Kaliux2412/Experimento_Abordo/Documentation/README.md

Aqui se explicará más a detalle cuál fue el proceso de desarrollo del experimento abordo.
