Kaliux2412/Experimento_Abordo/Archivos SVG/Placa 1 (LoRa).pdf

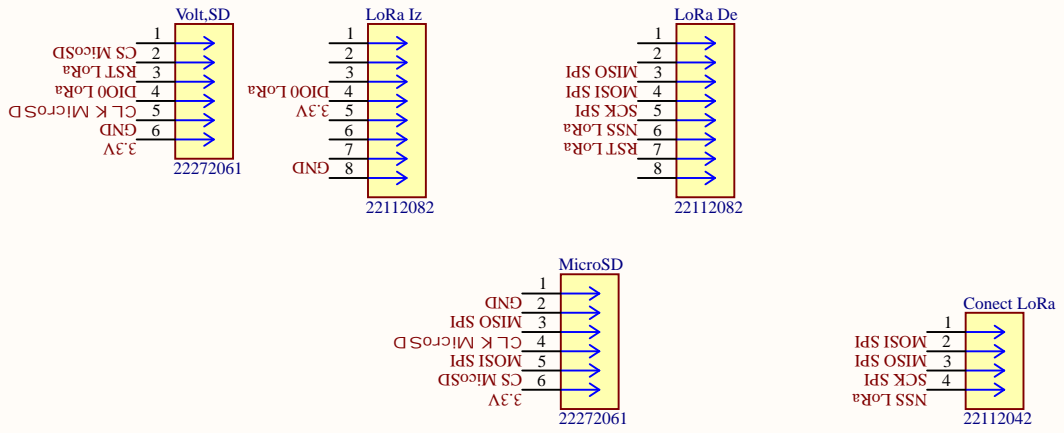
[picture p2: page 1]

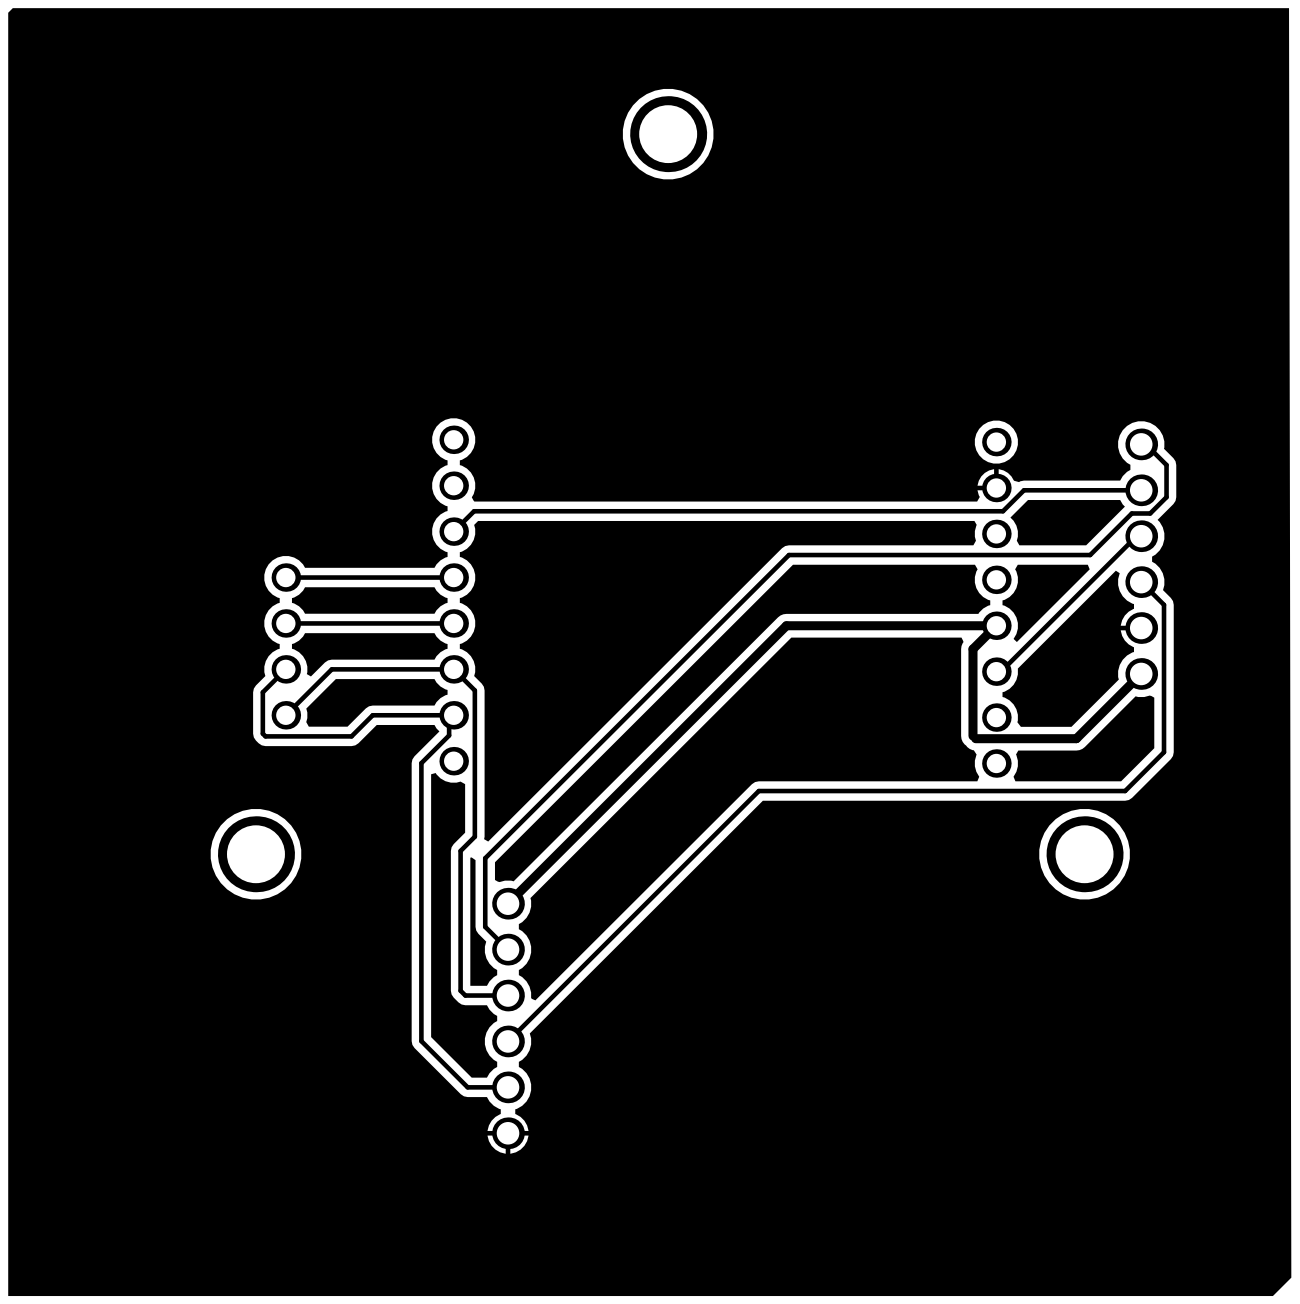
[picture p3: page 3]

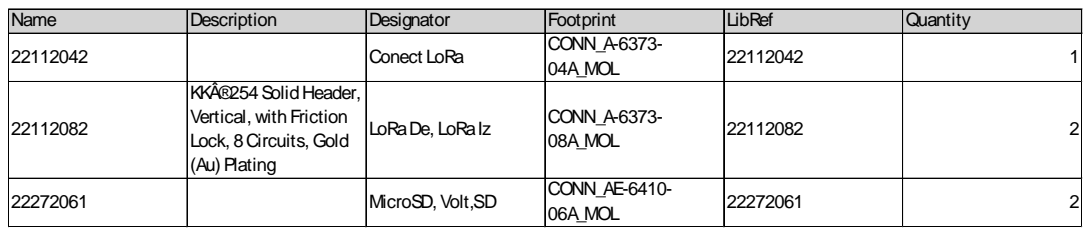
[picture p4: page 4]

Name | Description | Designator | Footprint | LibRef | Quantity
22112042 | | Conect LoRa | CONN_A-6373-04A_MOL | 22112042 | 1

22112082 | KKÂ®254SolidHeader, Vertical, withFriction Lock, 8Circuits, Gold (Au)Plating | LoRaDe, LoRaIz | CONN_A-6373-08A_MOL | 22112082 | 2

22272061 | | MicroSD, Volt,SD | CONN_AE-6410-06A_MOL | 22272061 | 2
