Kaliux2412/Experimento_Abordo/Archivos SVG/Placa 2 (GPS).pdf

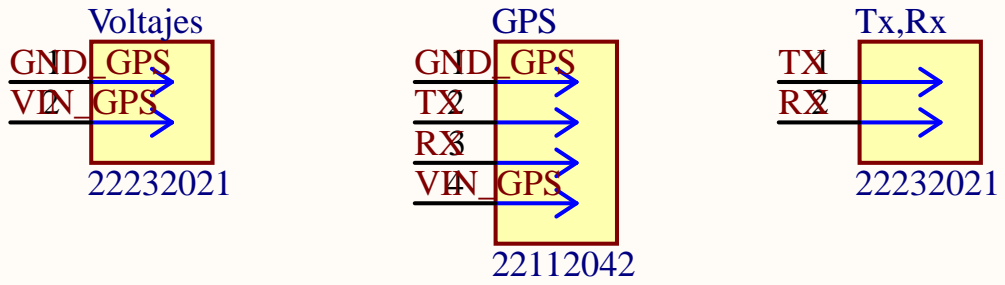
[picture p5: page 1]

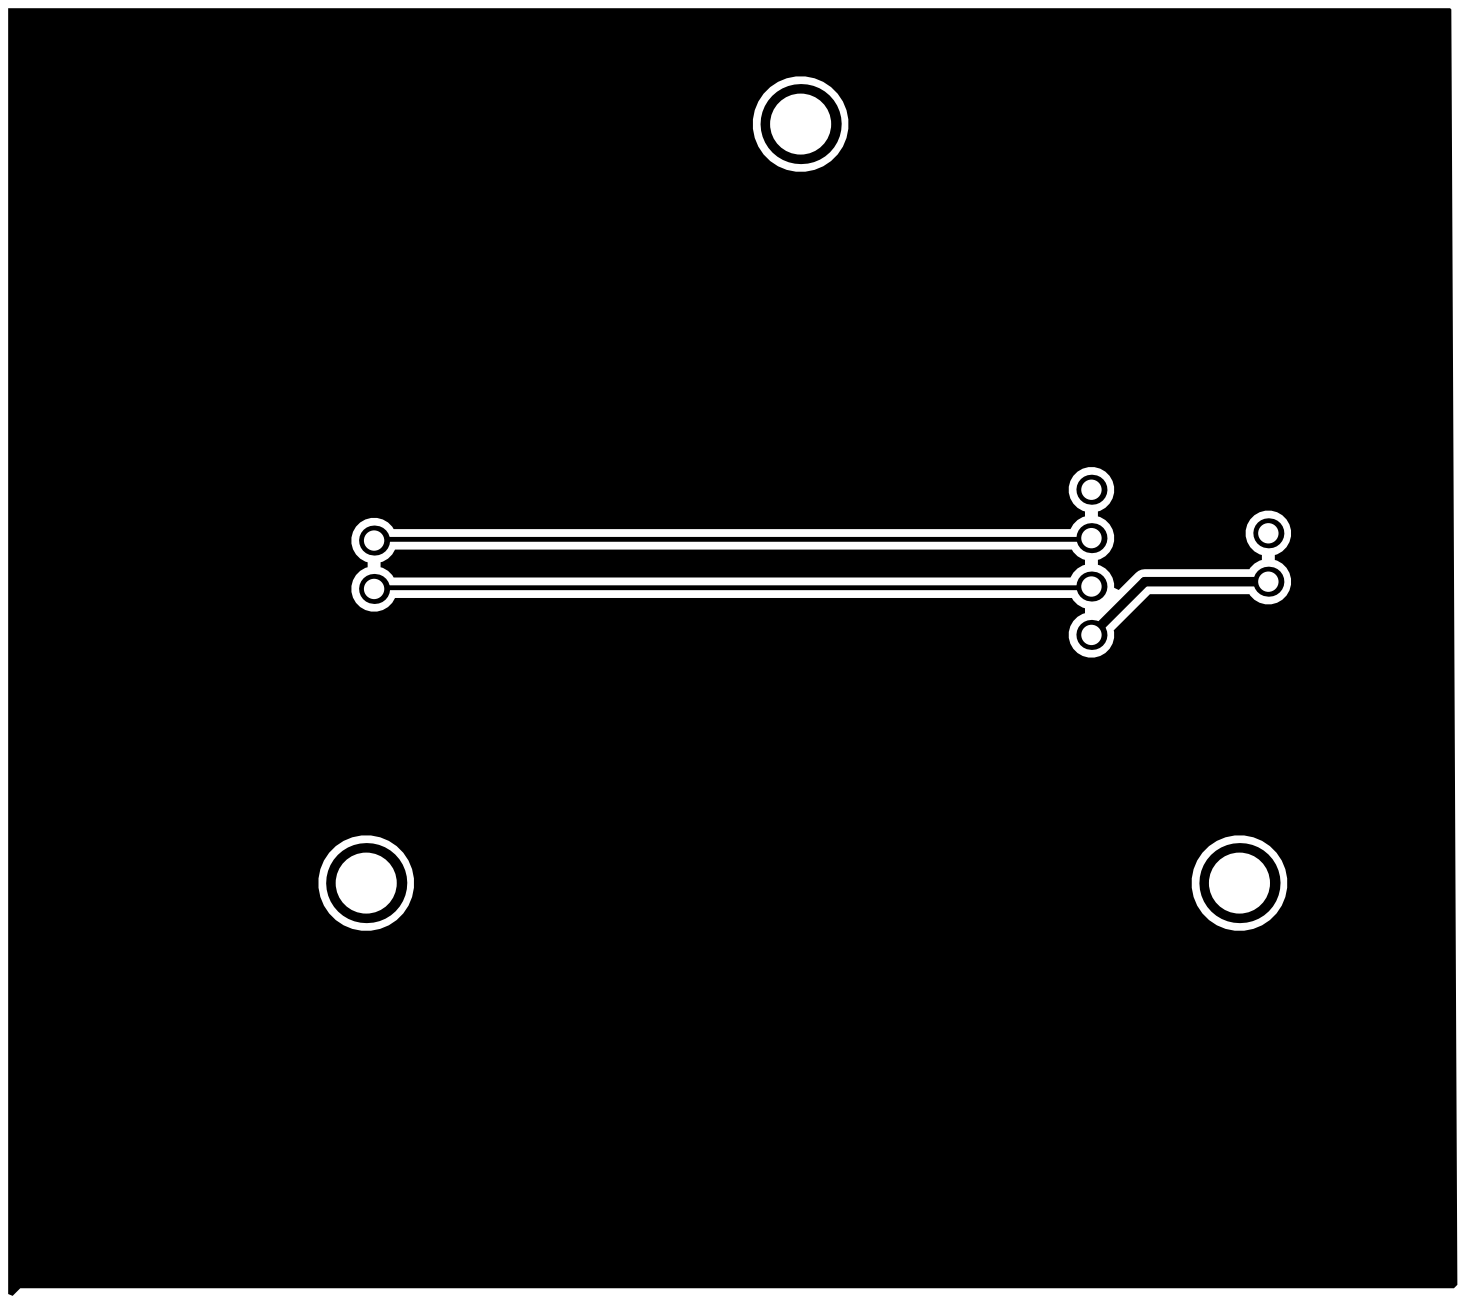
[picture p6: page 3]

Name | Description | Designator | Footprint | LibRef | Quantity
22112042 | | GPS | CONN_A-6373-04A_MOL | 22112042 | 1

22232021 | Connector Header ThroughHole2 position0.100 (2.54mm) | Tx,Rx, Voltajes | CONN_A-6373-02A_MOL | 22232021 | 2
