Kaliux2412/Experimento_Abordo/Archivos SVG/Placa 3 (ESP32).pdf

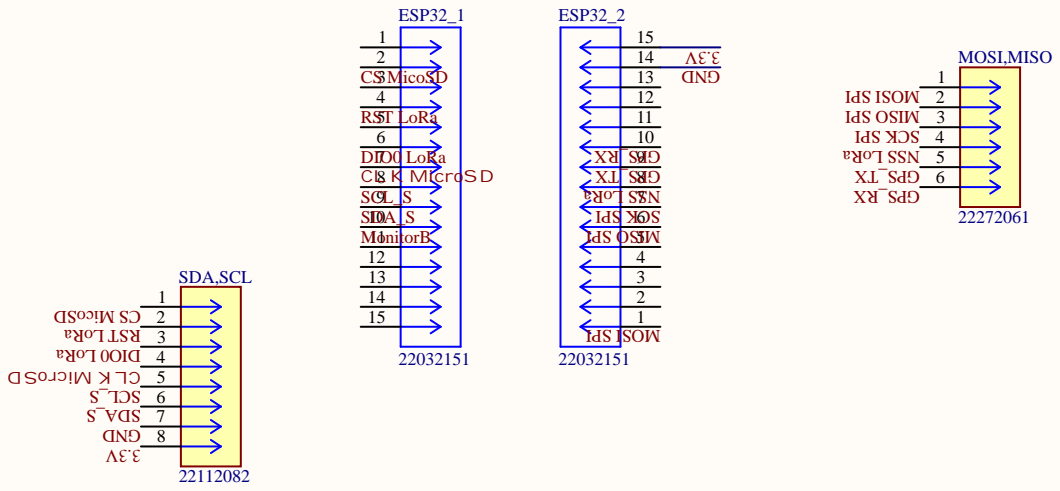
[picture p7: page 1]

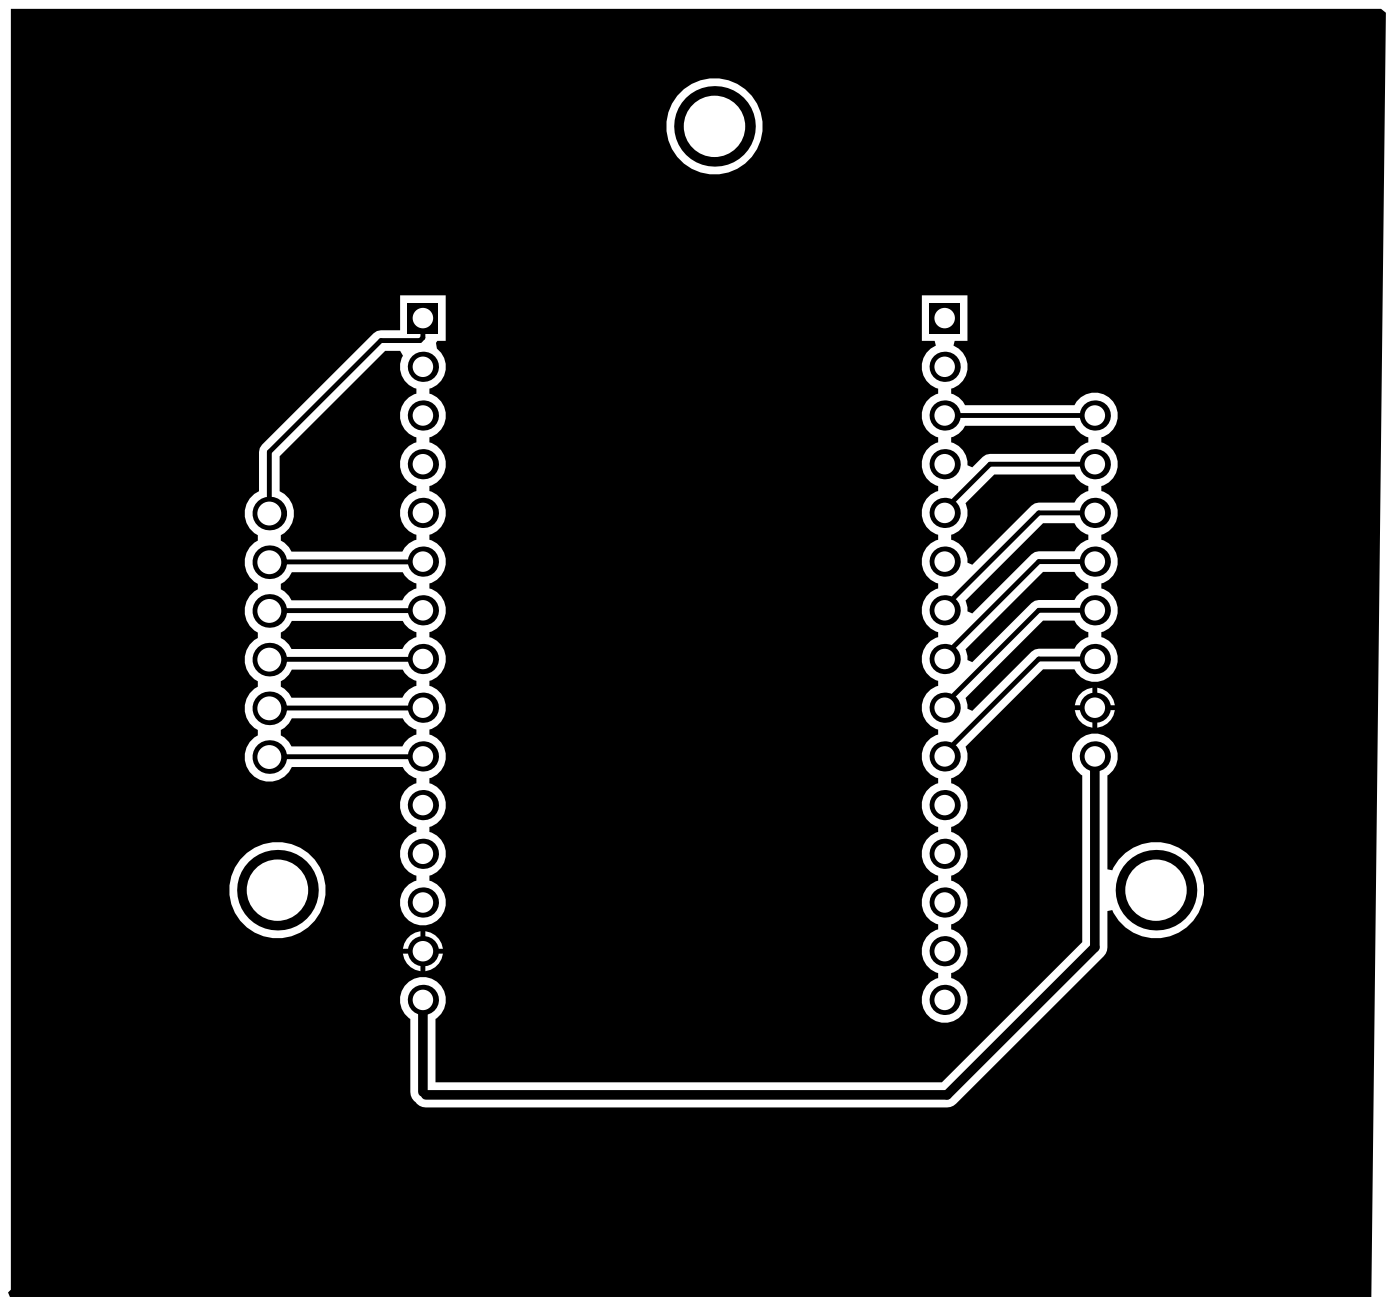
[picture p8: page 3]

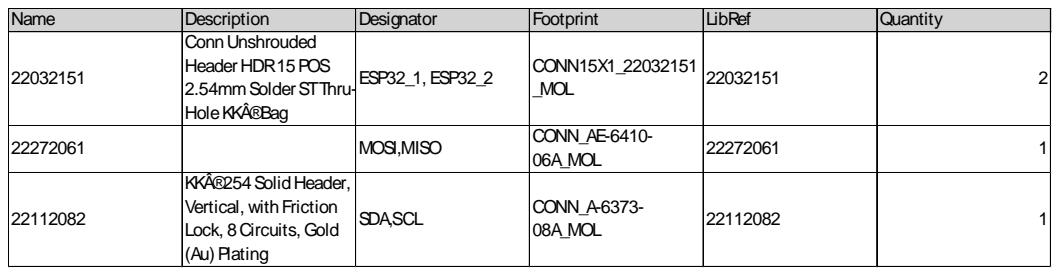
[picture p9: page 4]

Name | Description | Designator | Footprint | LibRef | Quantity
22032151 | ConnUnshrouded Header HDR15POS 2.54mmSolderSTThru-HoleKKÂ®Bag | ESP32_1, ESP32_2 | CONN15X1_22032151 _MOL | 22032151 | 2

22272061 | | MOSI,MISO | CONN_AE-6410-06A_MOL | 22272061 | 1

22112082 | KKÂ®254SolidHeader, Vertical, withFriction Lock, 8Circuits, Gold (Au)Plating | SDA,SCL | CONN_A-6373-08A_MOL | 22112082 | 1
