Kaliux2412/Experimento_Abordo/Documentation/IGNIS-1_esquematico_v0.pdf

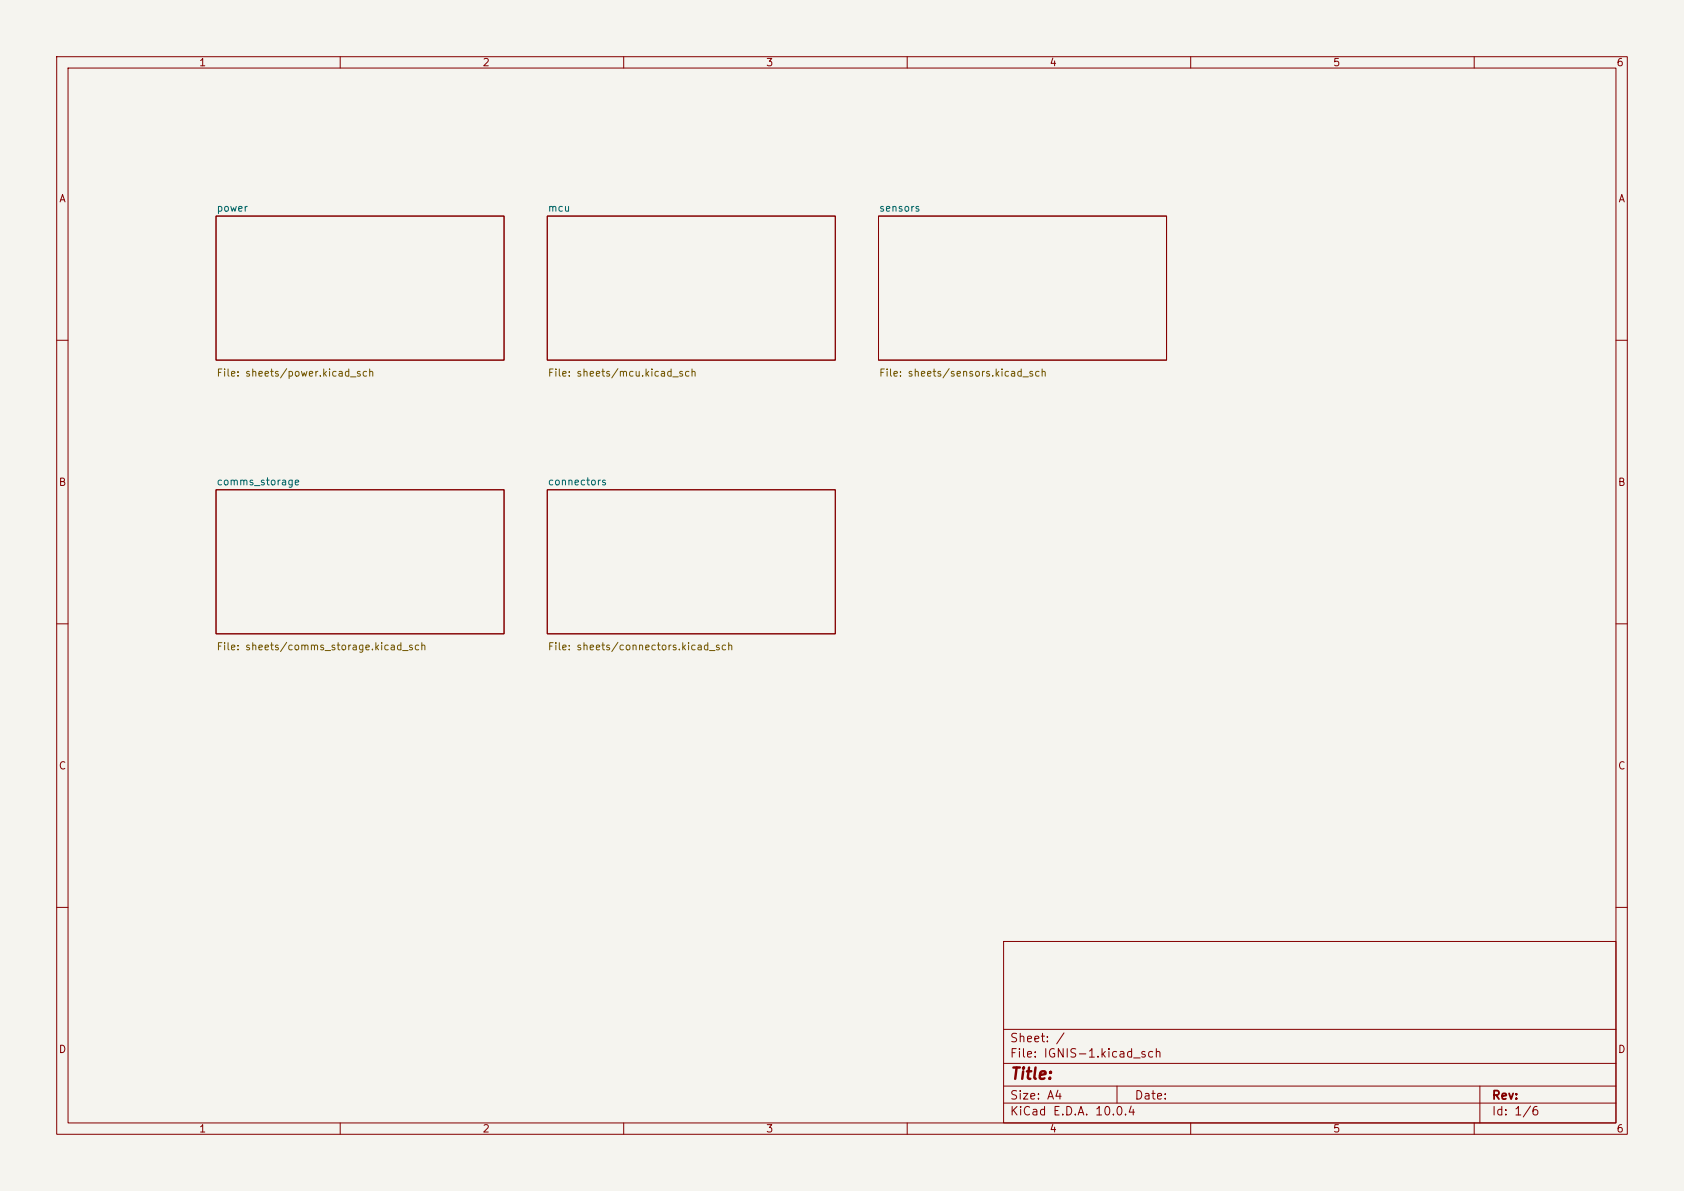
[picture p10: page 1]

sensors File: sheets/sensors.kicad_sch

connectors File: sheets/connectors.kicad_sch

Size: A4 | Rev:
KiCad E.D.A. 10.0.4 | Id: 1/6

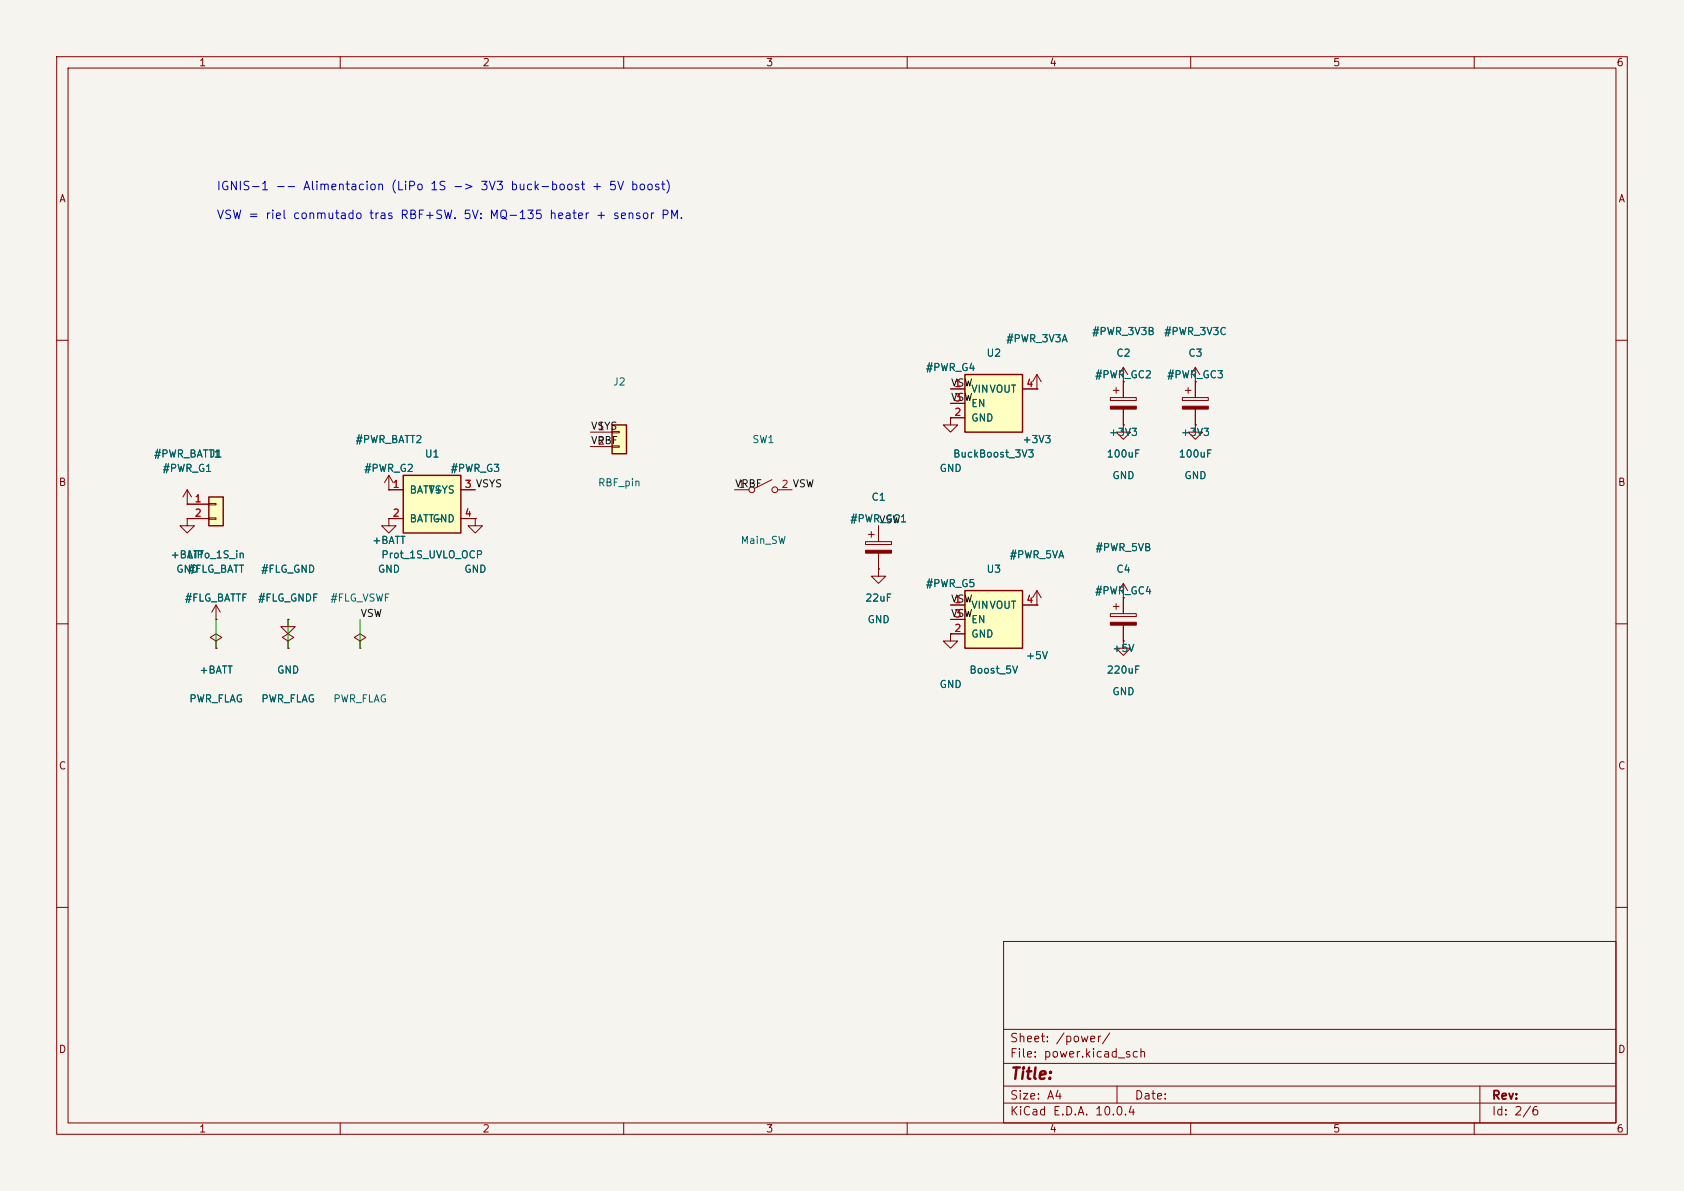
[picture p11: page 2]

IGNIS-1 -- Alimentacion (LiPo 1S -> 3V3 buck-boost + 5V boost)

VSW = riel conmutado tras RBF+SW. 5V: MQ-135 heater + sensor PM.

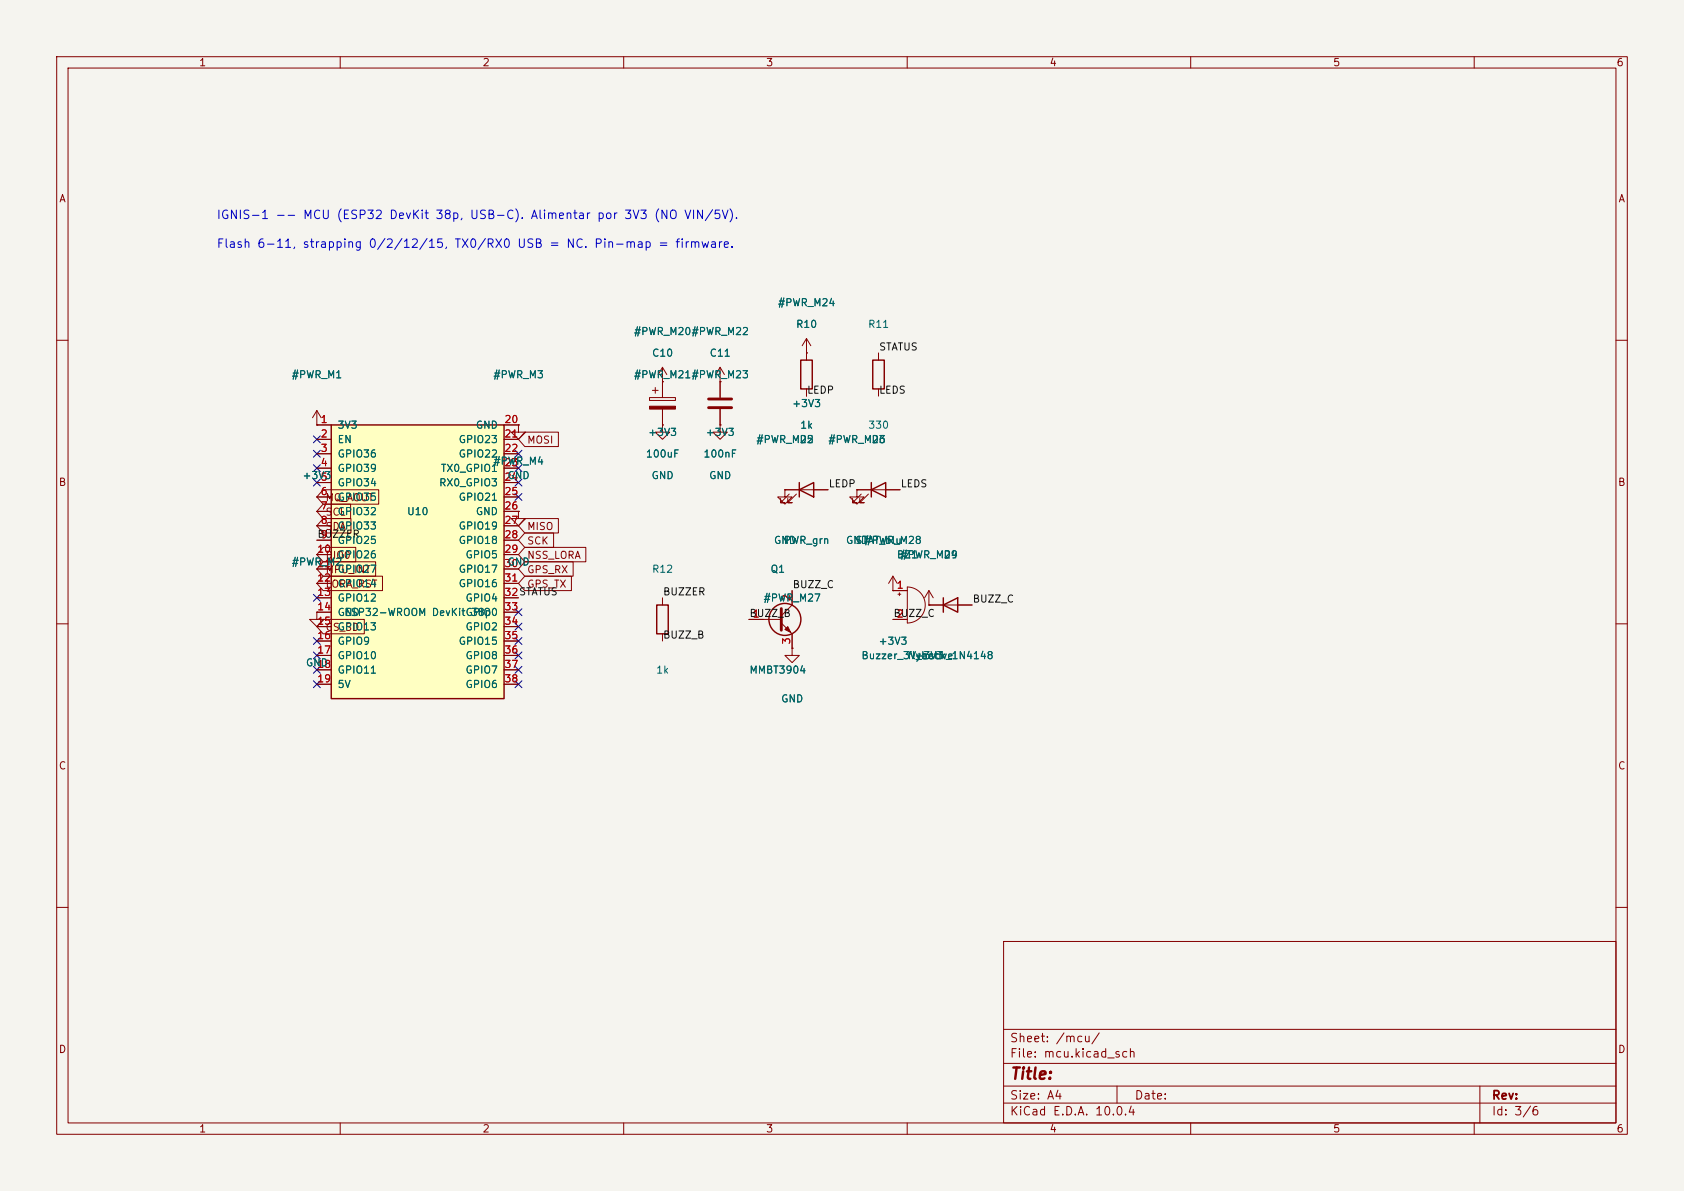
[picture p12: page 3]

BUZZ_B Flash 6-11, strapping 0/2/12/15, TX0/RX0 USB = NC. Pin-map = firmware.

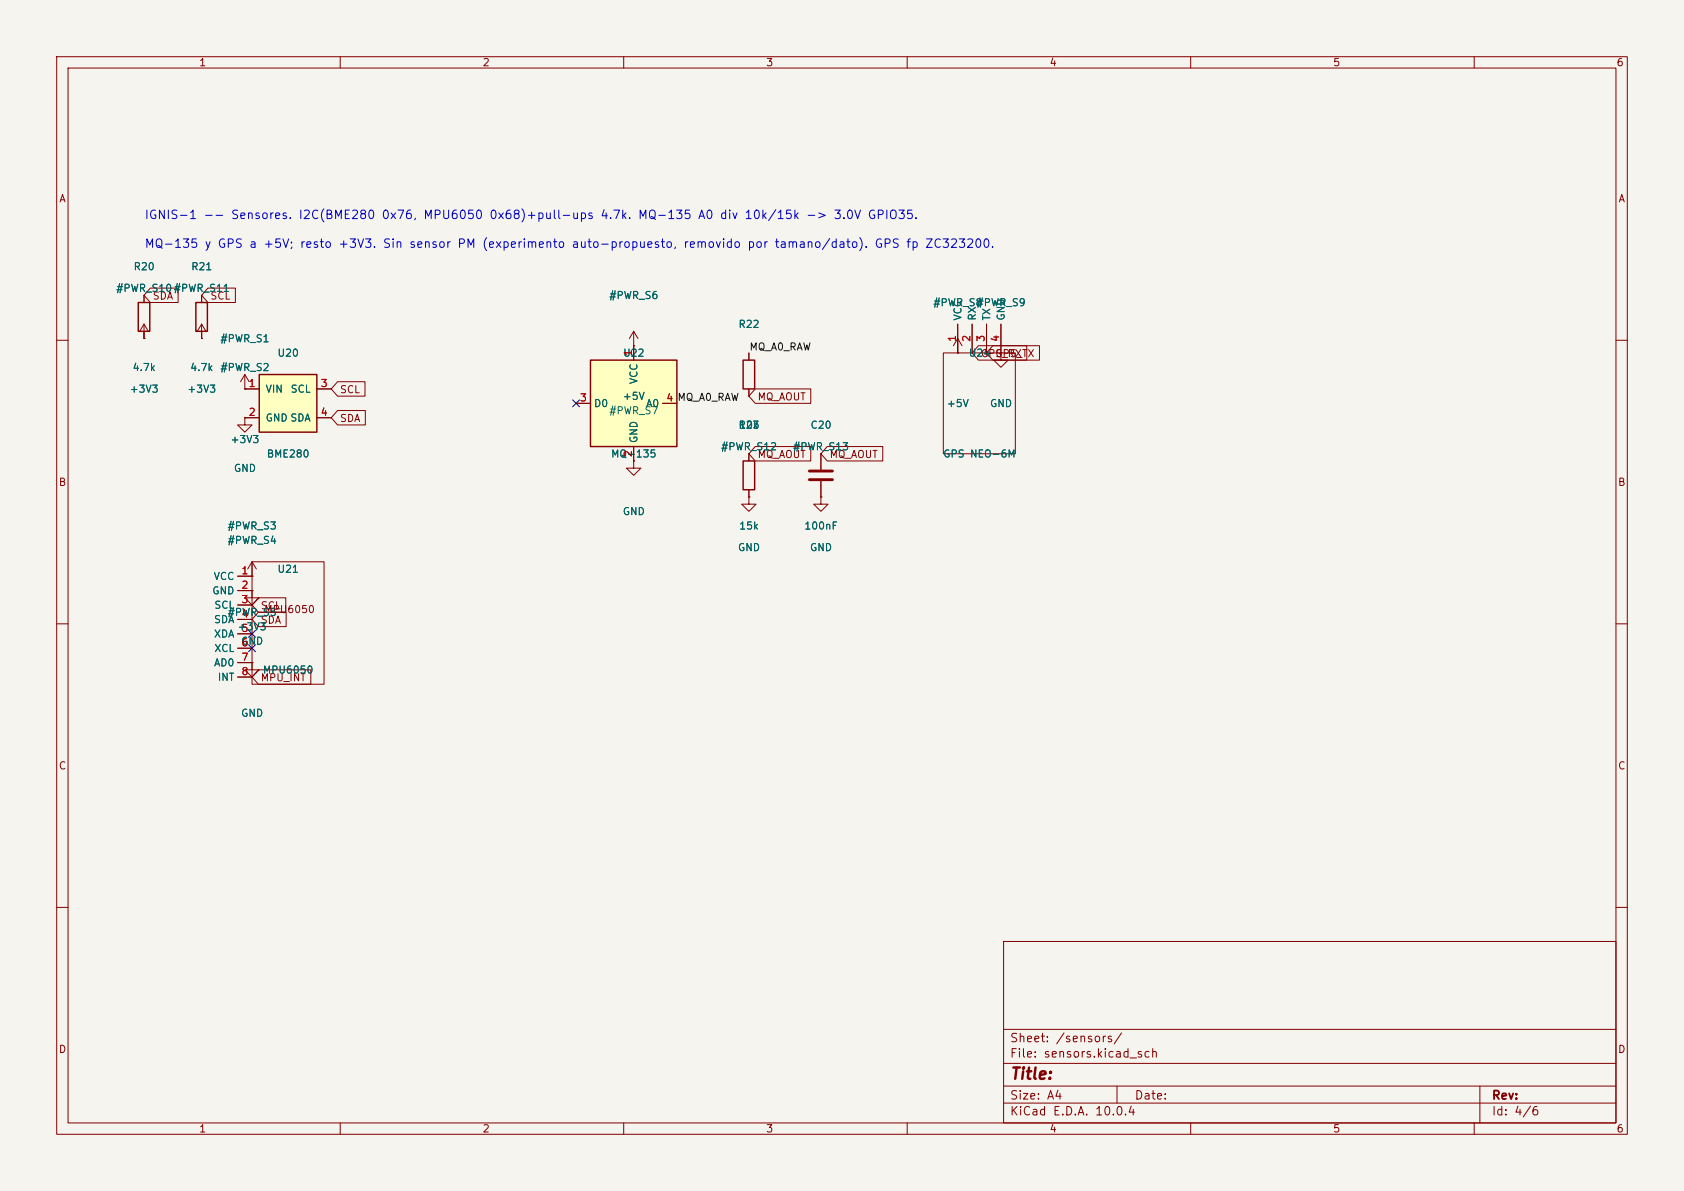
[picture p13: page 4]

IGNIS-1 -- Sensores. I2C(BME280 0x76, MPU6050 0x68)+pull-ups 4.7k. MQ-135 A0 div 10k/15k -> 3.0V GPIO35. R20

MQ_A0_RAW MQ-135 y GPS a +5V; resto +3V3. Sin sensor PM (experimento auto-propuesto, removido por tamano/dato). GPS fp ZC323200.

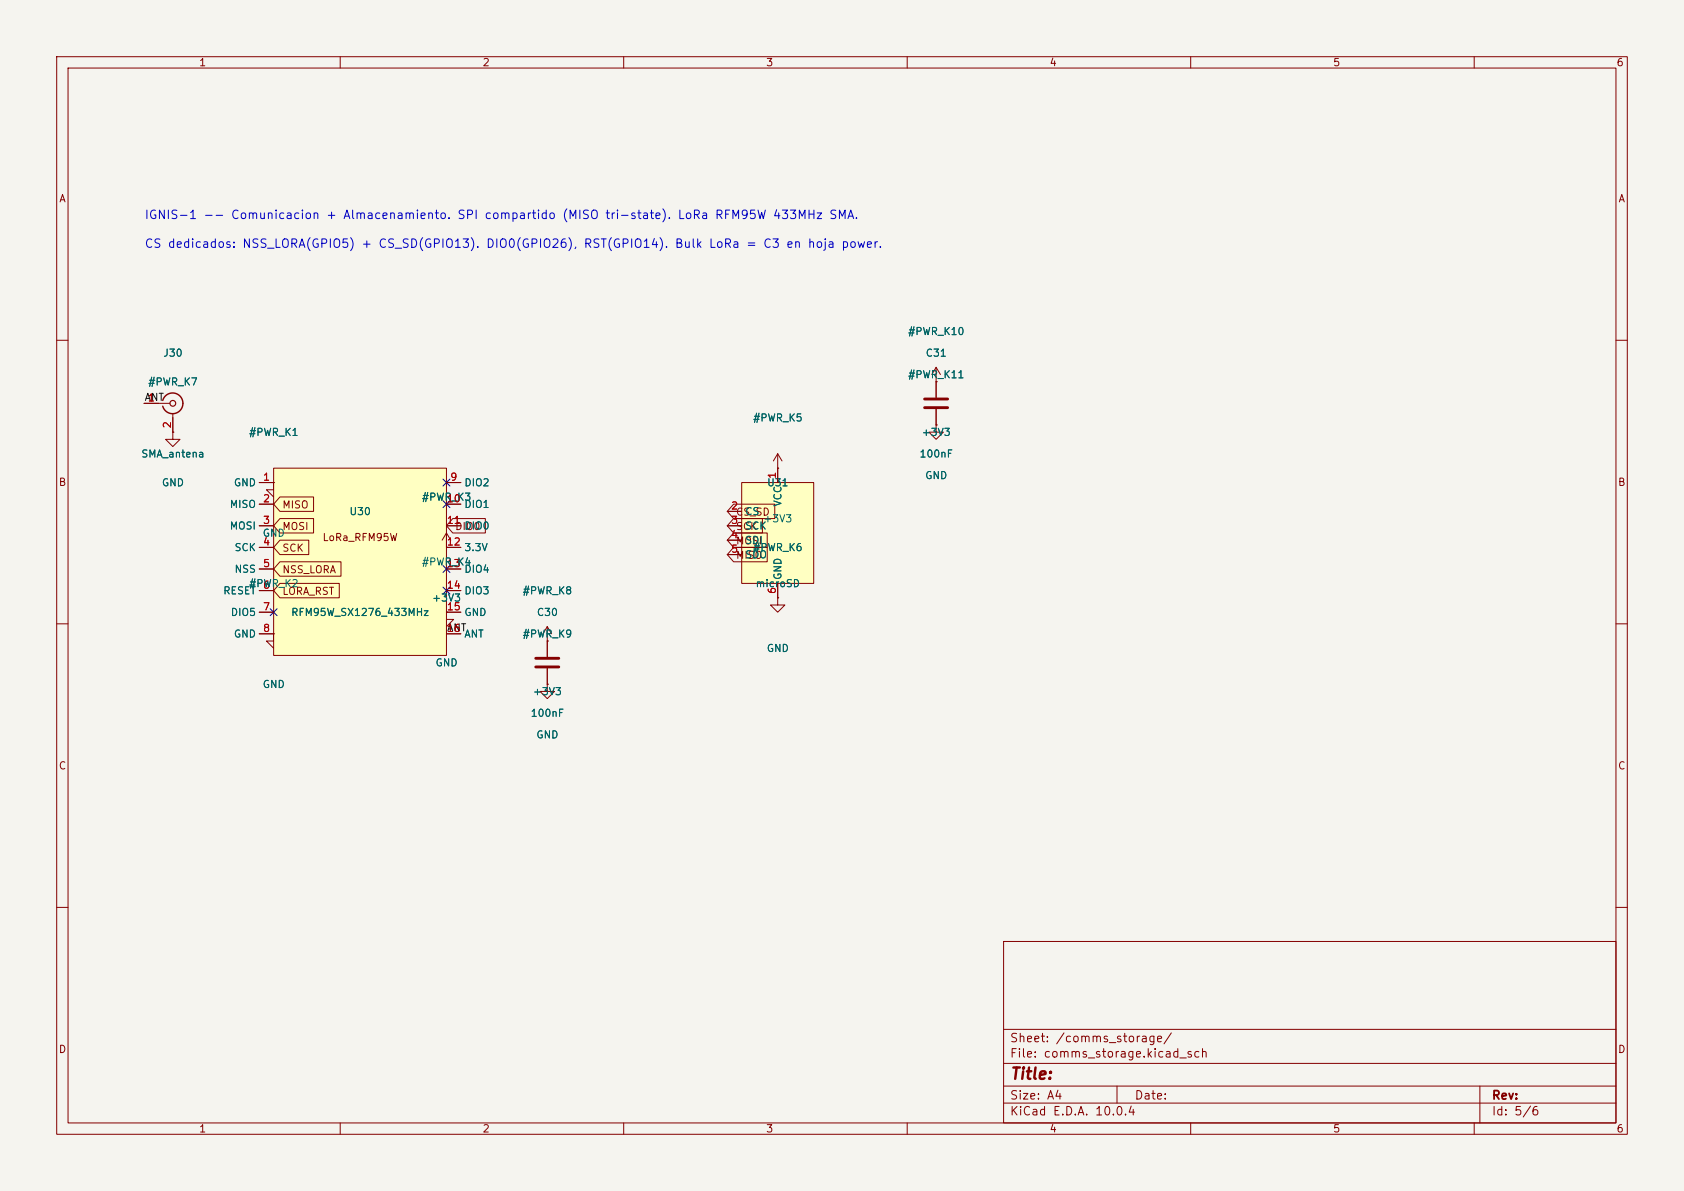
[picture p14: page 5]

IGNIS-1 -- Comunicacion + Almacenamiento. SPI compartido (MISO tri-state). LoRa RFM95W 433MHz SMA.

CS dedicados: NSS_LORA(GPIO5) + CS_SD(GPIO13). DIO0(GPIO26), RST(GPIO14). Bulk LoRa = C3 en hoja power.

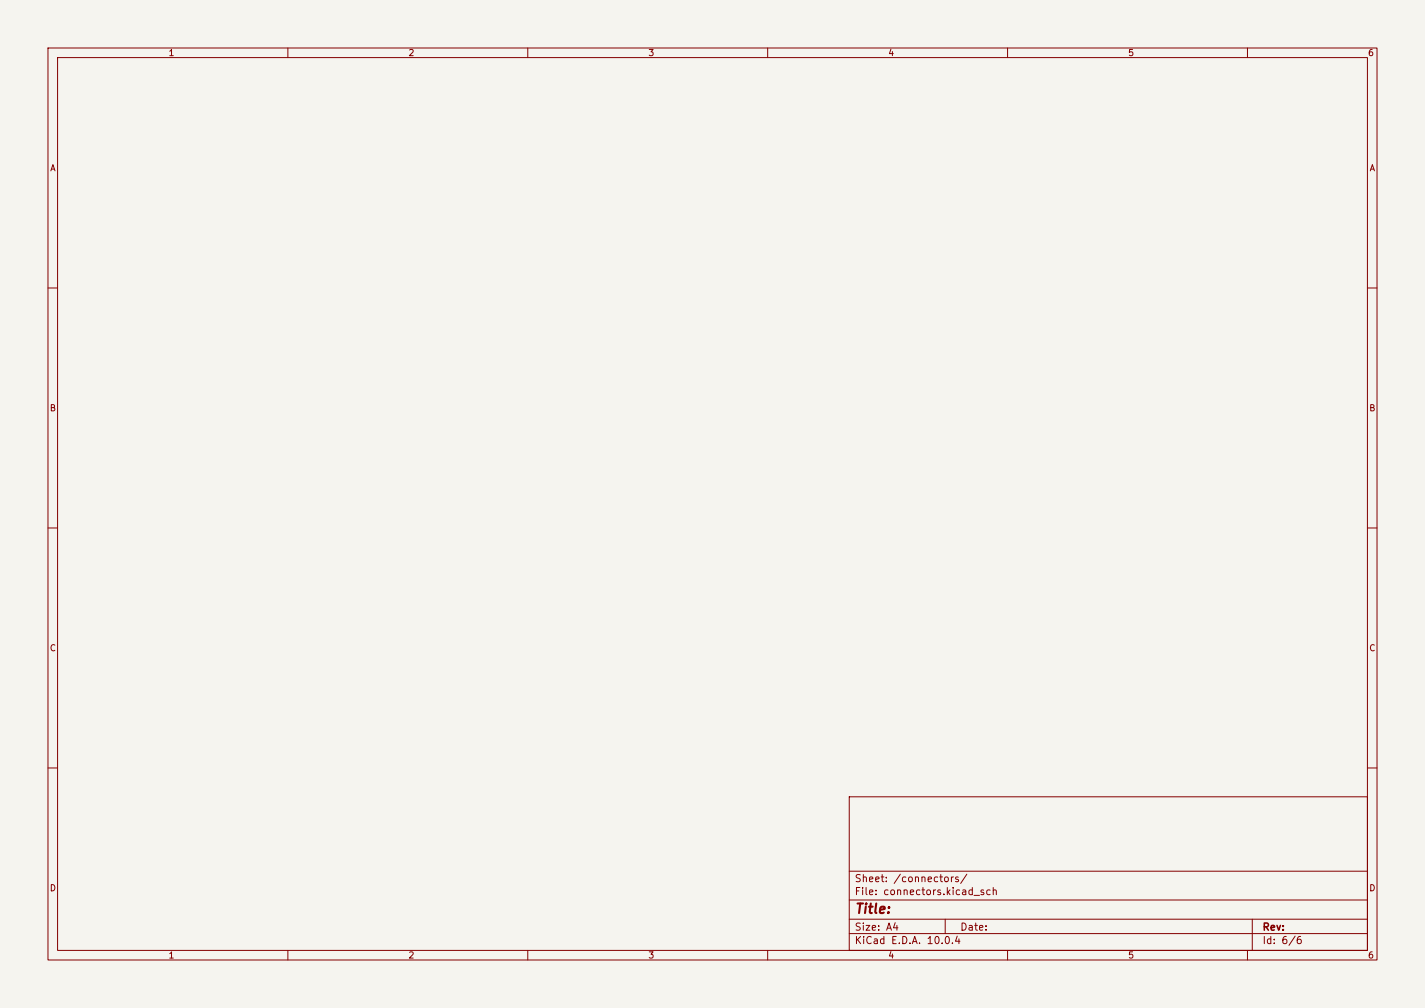
[picture p15: page 6]
