Kaliux2412/Experimento_Abordo/Documentation/IGNIS-1_placa_cerebro.pdf

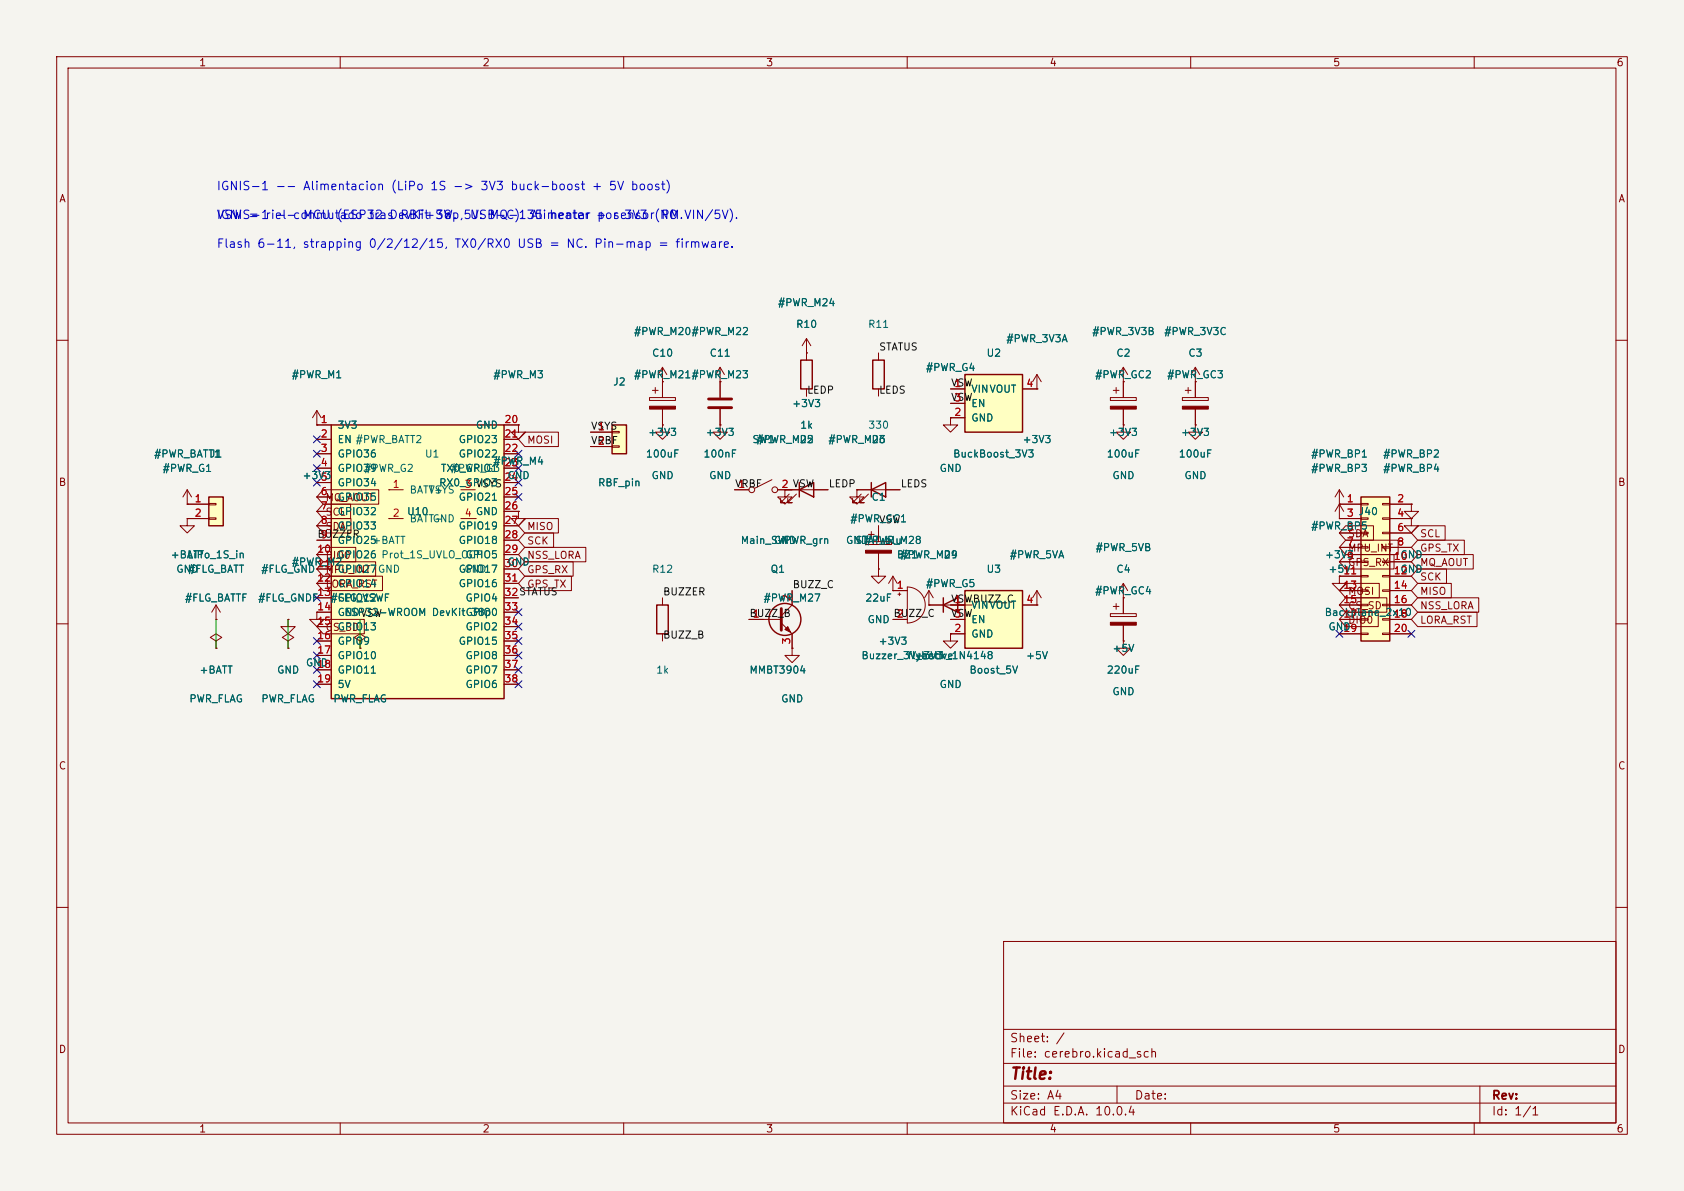
[picture p16: page 1]

IGNIS-1 -- Alimentacion (LiPo 1S -> 3V3 buck-boost + 5V boost)

IGNIS-1 -- MCU (ESP32 DevKit 38p, USB-C). Alimentar por 3V3 (NO VIN/5V).
VSW = riel conmutado tras RBF+SW. 5V: MQ-135 heater + sensor PM.

Flash 6-11, strapping 0/2/12/15, TX0/RX0 USB = NC. Pin-map = firmware.

Size: A4 | Rev:
KiCad E.D.A. 10.0.4 | Id: 1/1
