Kaliux2412/Experimento_Abordo/Documentation/IGNIS-1_placa_sensores.pdf

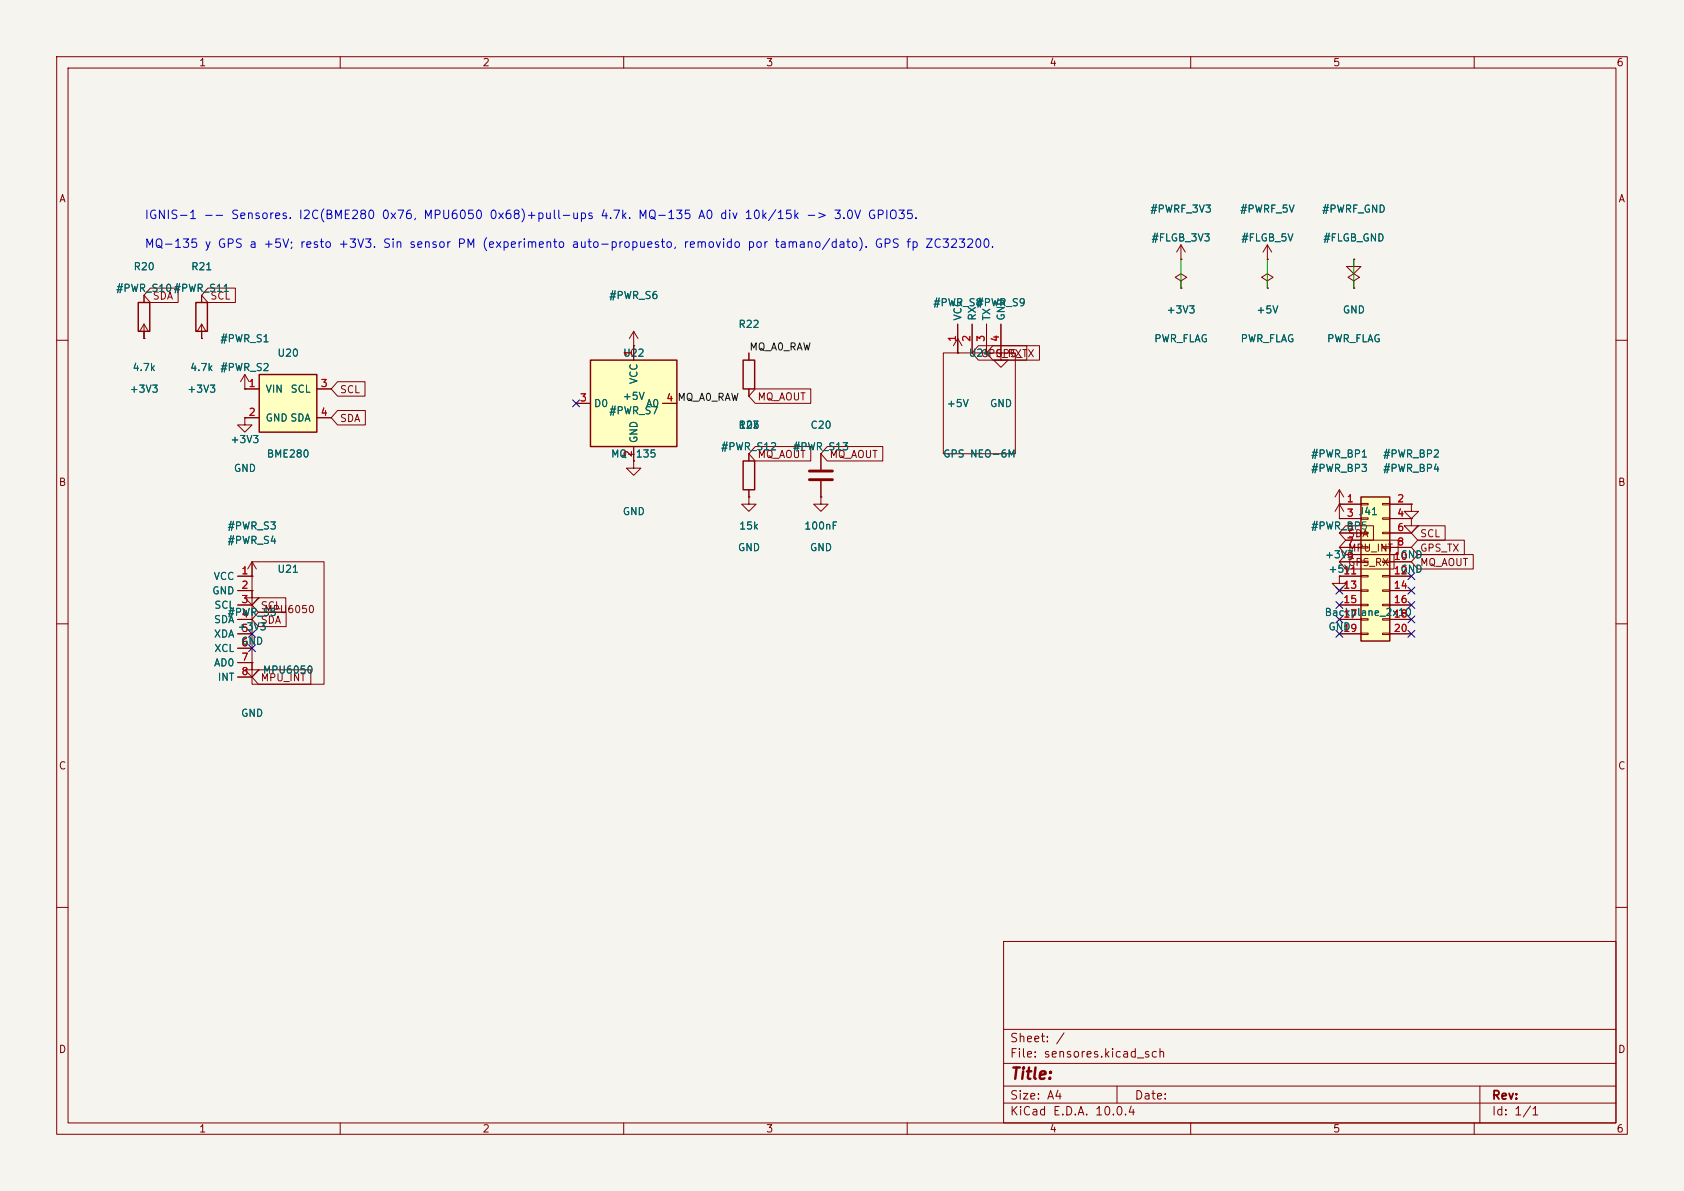
[picture p17: page 1]
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

MQ-135 y GPS a +5V; resto +3V3. Sin sensor PM (experimento auto-propuesto, removido por tamano/dato). GPS fp ZC323200. U20 BME280

Size: A4 | Rev:
KiCad E.D.A. 10.0.4 | Id: 1/1
