Kaliux2412/Experimento_Abordo/Archivos SVG/Placa5.pdf

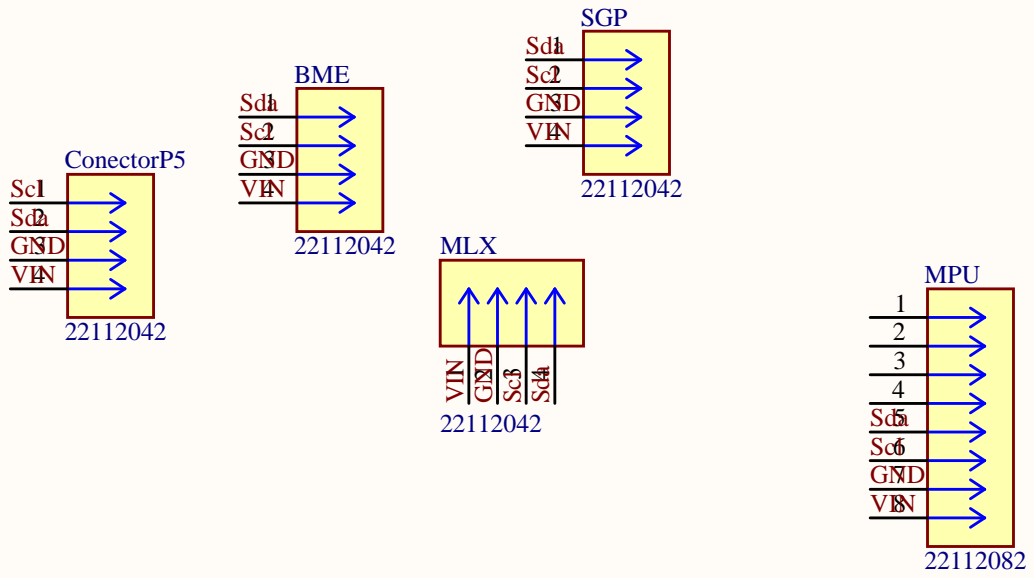
[picture p18: page 1]

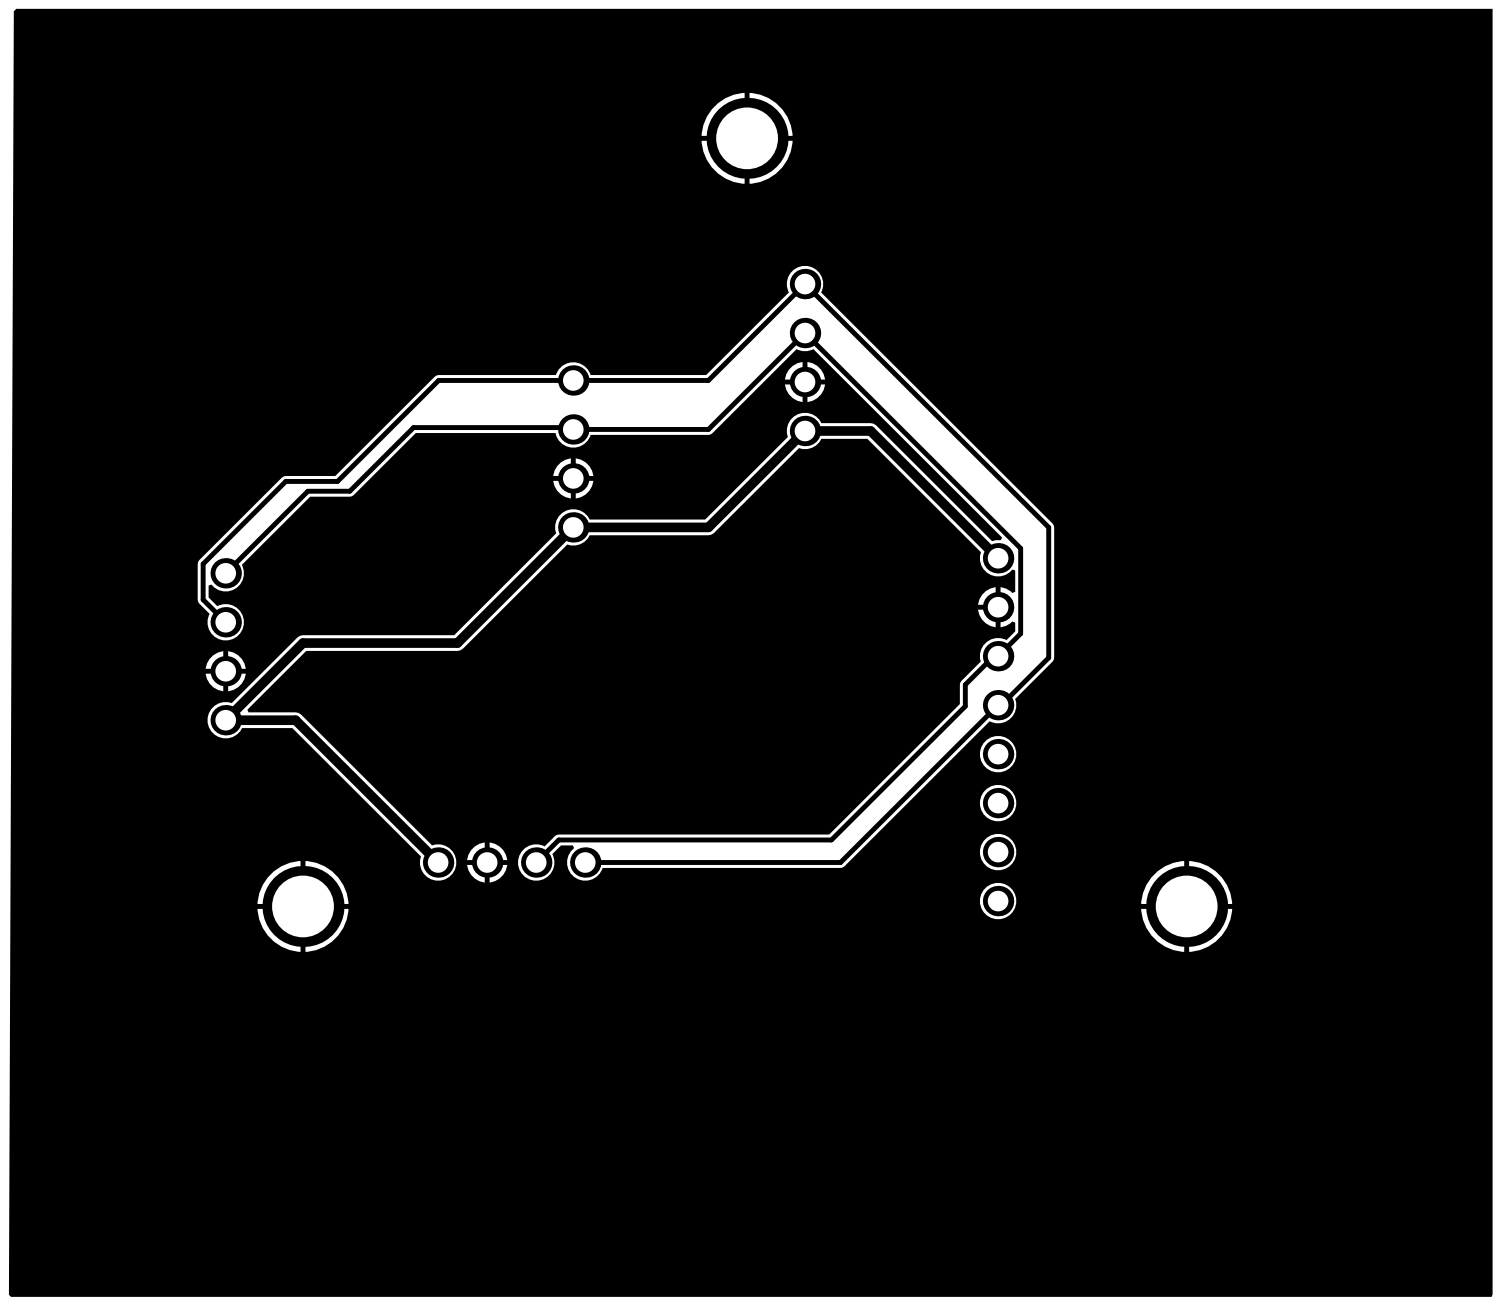
[picture p19: page 3]
