Kaliux2412/Experimento_Abordo/(list of files, drawings)

Other design files:
Altium/PCB_Project.PrjPcb
Altium/Placa1/Placa1.PcbDoc
Altium/Placa1/Placa1.SchDoc
Altium/Placa1/Placa 1 (LoRa).PrjPcb
Altium/Placa2/Placa2.SchDoc
Altium/Placa2/Placa 2 (GPS).PrjPcb
Altium/Placa2/Placa 2.PcbDoc
Altium/Placa3/Placa3.PcbDoc
Altium/Placa3/Placa3.SchDoc
Altium/Placa3/Placa 3 (ESP32).PrjPcb
Altium/Placa5.PrjPcb
Altium/Placa5/Placa5.PrjPcb
Altium/Placa5/Placa 5 (Sensores).SchDoc
Altium/Placa5/Placa 5.PcbDoc
Altium/Placa_Principal_PCB.PcbDoc
Altium/Placa_Principal_Schematic.SchDoc
