Kaliux2412/Experimento_Abordo/KiCad/IGNIS-1/placa_poder_cerebro/placa_poder_cerebro.kicad_pcb

## KiCad design KiCad/IGNIS-1/placa_poder_cerebro/placa_poder_cerebro.kicad_pcb (2026-07-23)

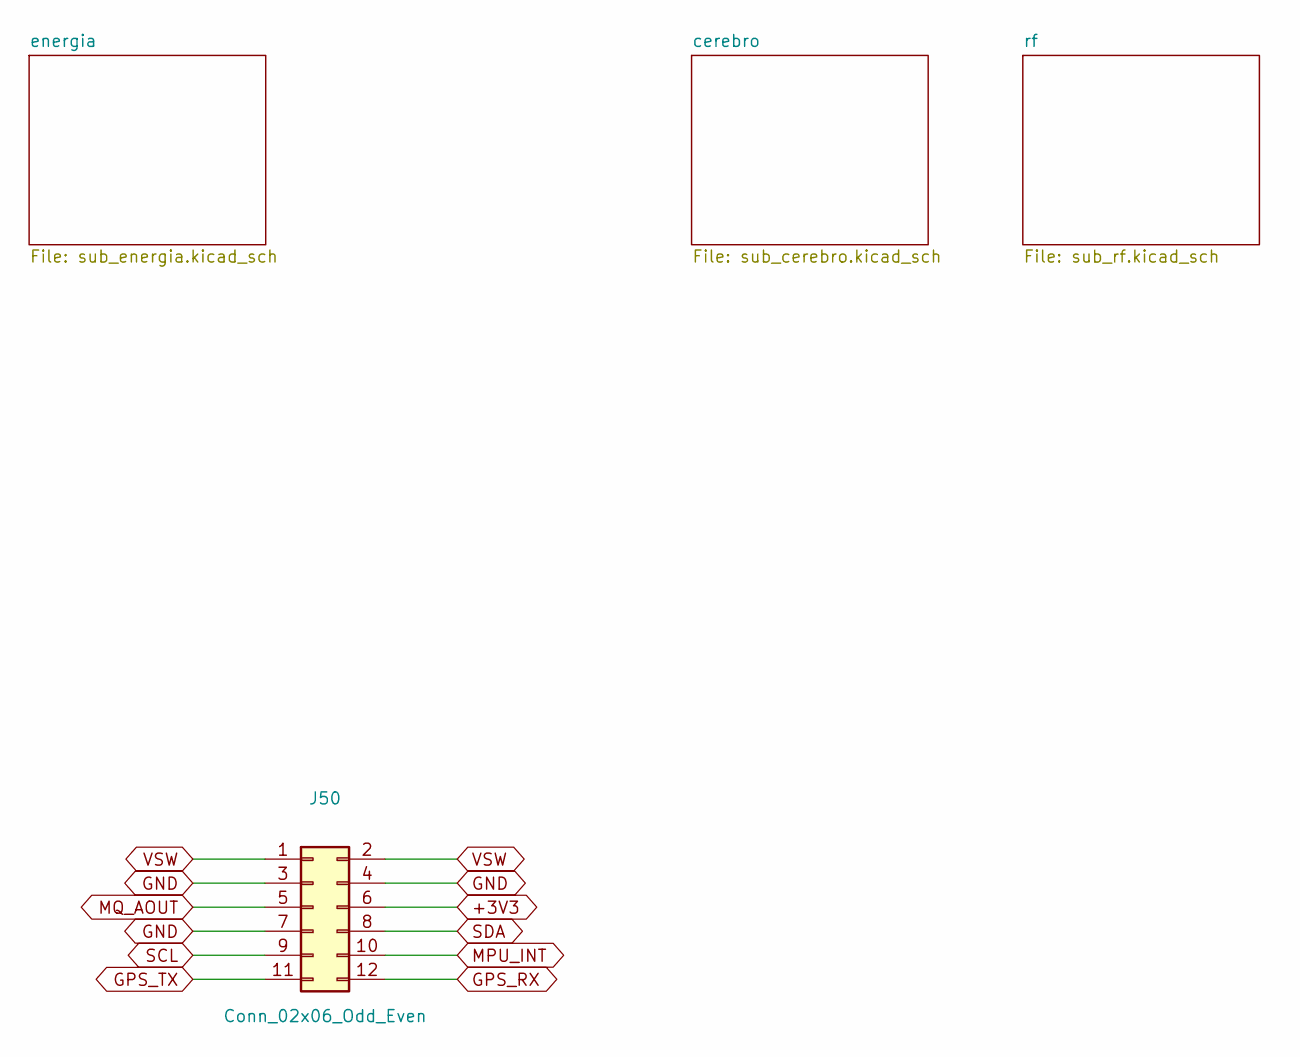
[picture p20: schematic placa_poder_cerebro.kicad_sch, IGNIS-1 Poder+Cerebro]

Parts:
J50: Conn_02x06_Odd_Even; PinHeader_2x06_P2.54mm_Vertical

Connections:
+3V3: J50.6; also elsewhere on the board
GND: J50.3, J50.4, J50.7; also elsewhere on the board
GPS_RX: J50.12; also elsewhere on the board
GPS_TX: J50.11; also elsewhere on the board
MPU_INT: J50.10; also elsewhere on the board
MQ_AOUT: J50.5; also elsewhere on the board
SCL: J50.9; also elsewhere on the board
SDA: J50.8; also elsewhere on the board
VSW: J50.1, J50.2; also elsewhere on the board

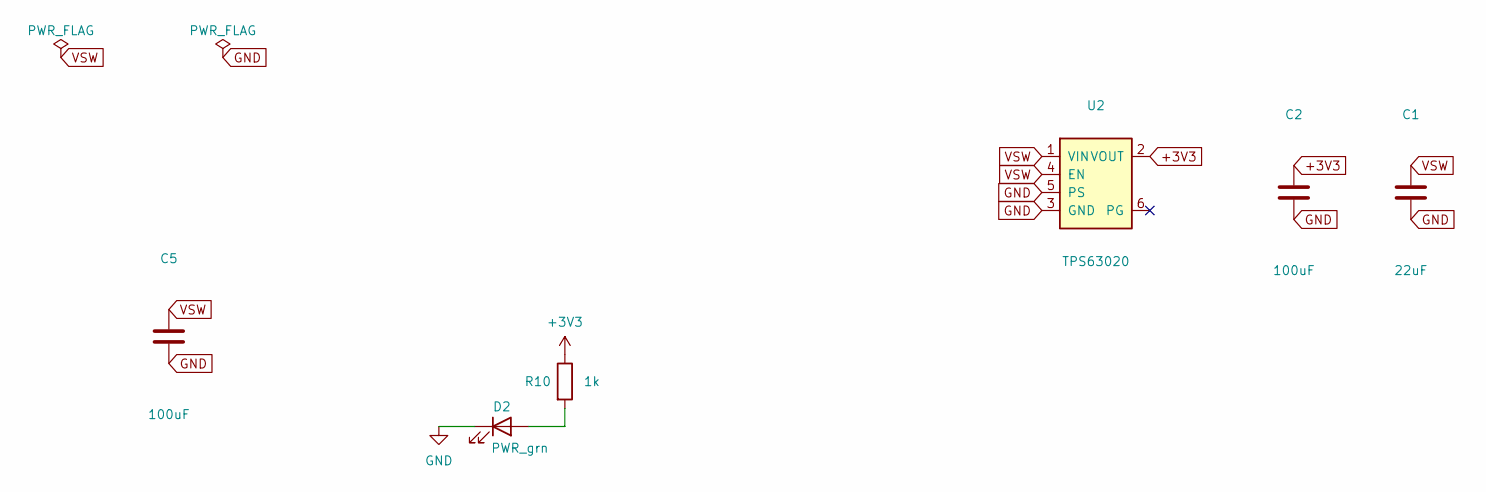
[picture p21: schematic sub_energia.kicad_sch]

Parts:
C1: 22uF; C_1206_3216Metric
C2, C5: 100uF; C_1210_3225Metric
D2: PWR_grn; LED_D3.0mm
R10: 1k; R_0805_2012Metric
U2: TPS63020; TPS63020_module

Connections:
+3V3: C2.1, R10.1, U2.2 (VOUT); also elsewhere on the board
GND: C1.2, C2.2, C5.2, D2.1 (K), U2.3 (GND), U2.5 (PS); also elsewhere on the board
unnamed: D2.2 (A), R10.2
VSW: C1.1, C5.1, U2.1 (VIN), U2.4 (EN); also elsewhere on the board

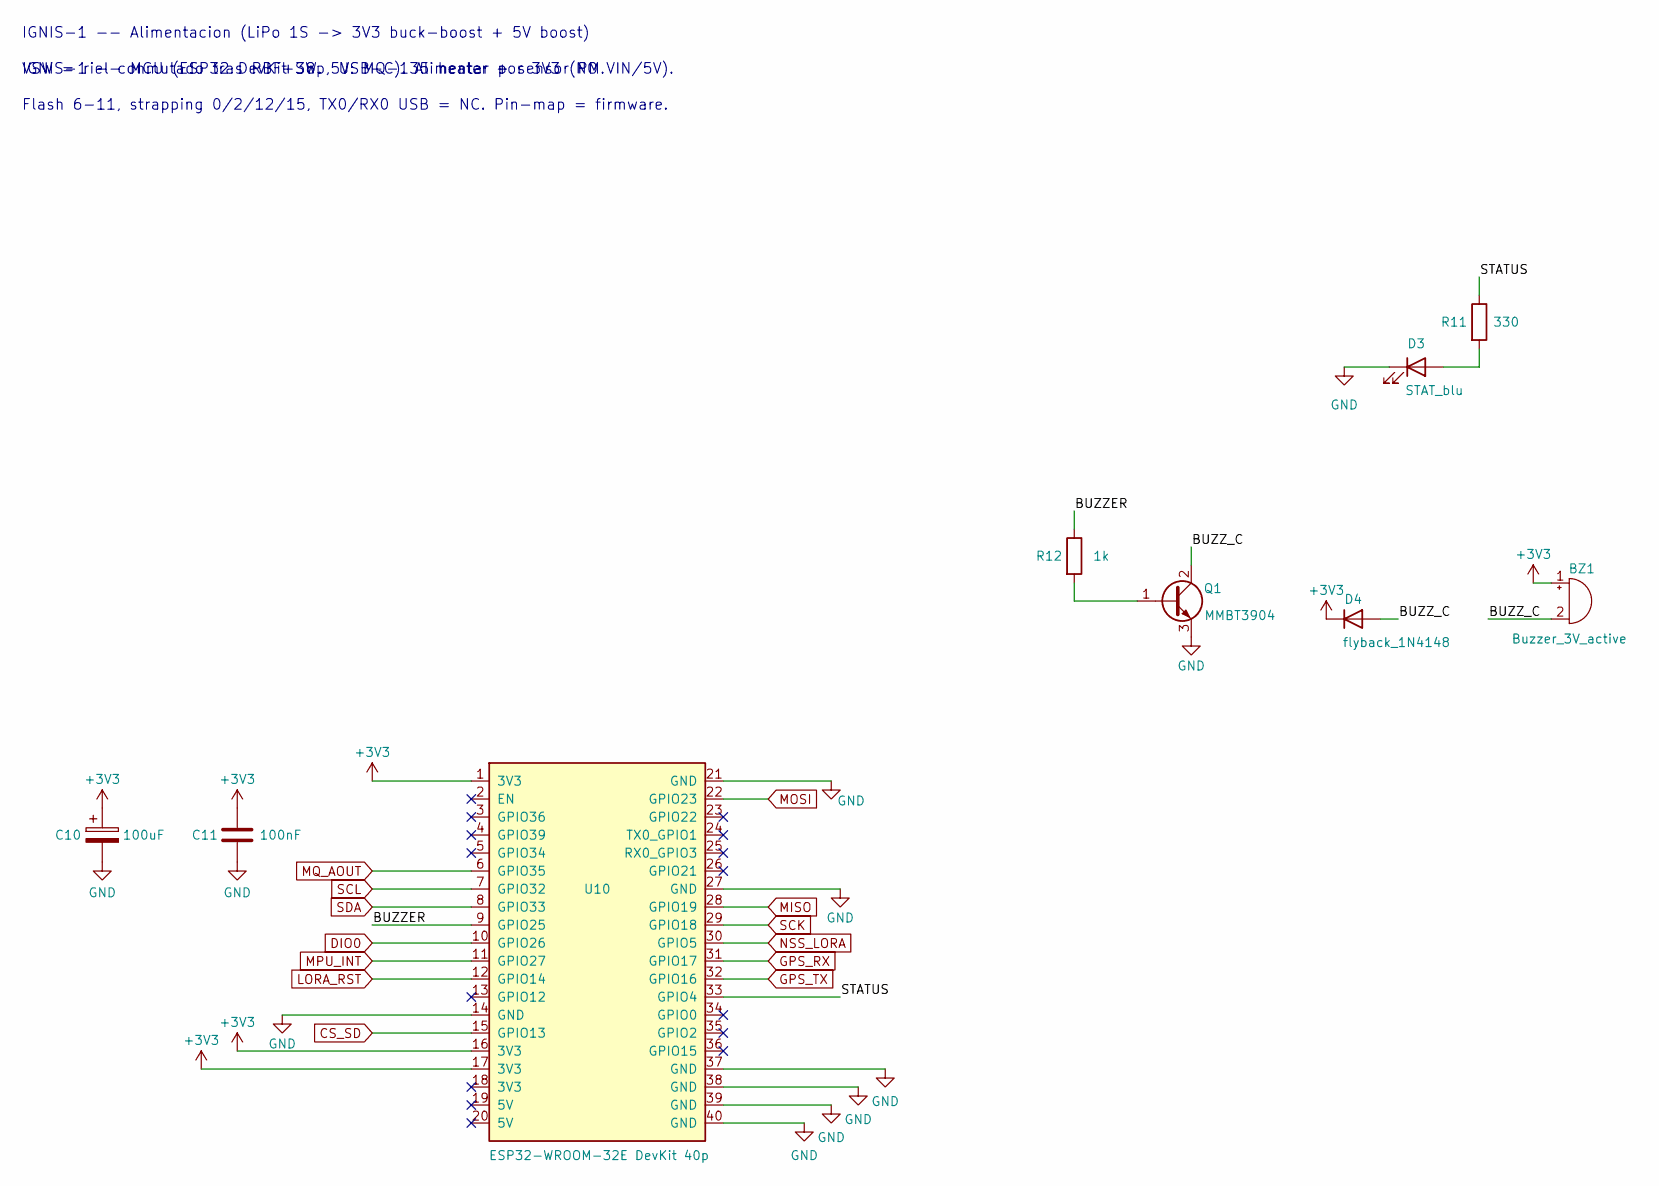
[picture p22: schematic sub_cerebro.kicad_sch]

Parts:
BZ1: Buzzer_3V_active; Buzzer_D12_P8.41
C10: 100uF; C_1210_3225Metric
C11: 100nF; C_0805_2012Metric
D3: STAT_blu; LED_D3.0mm
D4: flyback_1N4148; D_DO-35_SOD27_P7.62mm_Horizontal
Q1: MMBT3904; Q_TO92_2N3904_EBC
R11: 330; R_0805_2012Metric
R12: 1k; R_0805_2012Metric
U10: ESP32-WROOM-32E DevKit 40p; ESP32_DevKit_40p

Connections:
+3V3: BZ1.1 (+), C10.1, C11.1, D4.1 (K), U10.1 (3V3), U10.16 (3V3), U10.17 (3V3); also elsewhere on the board
/cerebro/BUZZER: R12.1, U10.9 (GPIO25)
/cerebro/BUZZ_C: BZ1.2 (-), D4.2 (A), Q1.2 (C)
/cerebro/STATUS: R11.1, U10.33 (GPIO4)
CS_SD: U10.15 (GPIO13); also elsewhere on the board
DIO0: U10.10 (GPIO26); also elsewhere on the board
GND: C10.2, C11.2, D3.1 (K), Q1.3 (E), U10.14 (GND), U10.21 (GND), U10.27 (GND), U10.37 (GND), U10.38 (GND), U10.39 (GND), U10.40 (GND); also elsewhere on the board
GPS_RX: U10.31 (GPIO17); also elsewhere on the board
GPS_TX: U10.32 (GPIO16); also elsewhere on the board
LORA_RST: U10.12 (GPIO14); also elsewhere on the board
MISO: U10.28 (GPIO19); also elsewhere on the board
MOSI: U10.22 (GPIO23); also elsewhere on the board
MPU_INT: U10.11 (GPIO27); also elsewhere on the board
MQ_AOUT: U10.6 (GPIO35); also elsewhere on the board
NSS_LORA: U10.30 (GPIO5); also elsewhere on the board
unnamed: D3.2 (A), R11.2
unnamed: Q1.1 (B), R12.2
SCK: U10.29 (GPIO18); also elsewhere on the board
SCL: U10.7 (GPIO32); also elsewhere on the board
SDA: U10.8 (GPIO33); also elsewhere on the board

Notes on the sheet:
VSW = riel conmutado tras RBF+SW. 5V: MQ-135 heater + sensor PM.
Flash 6-11, strapping 0/2/12/15, TX0/RX0 USB = NC. Pin-map = firmware.
IGNIS-1 -- Alimentacion (LiPo 1S -> 3V3 buck-boost + 5V boost)
IGNIS-1 -- MCU (ESP32 DevKit 38p, USB-C). Alimentar por 3V3 (NO VIN/5V).

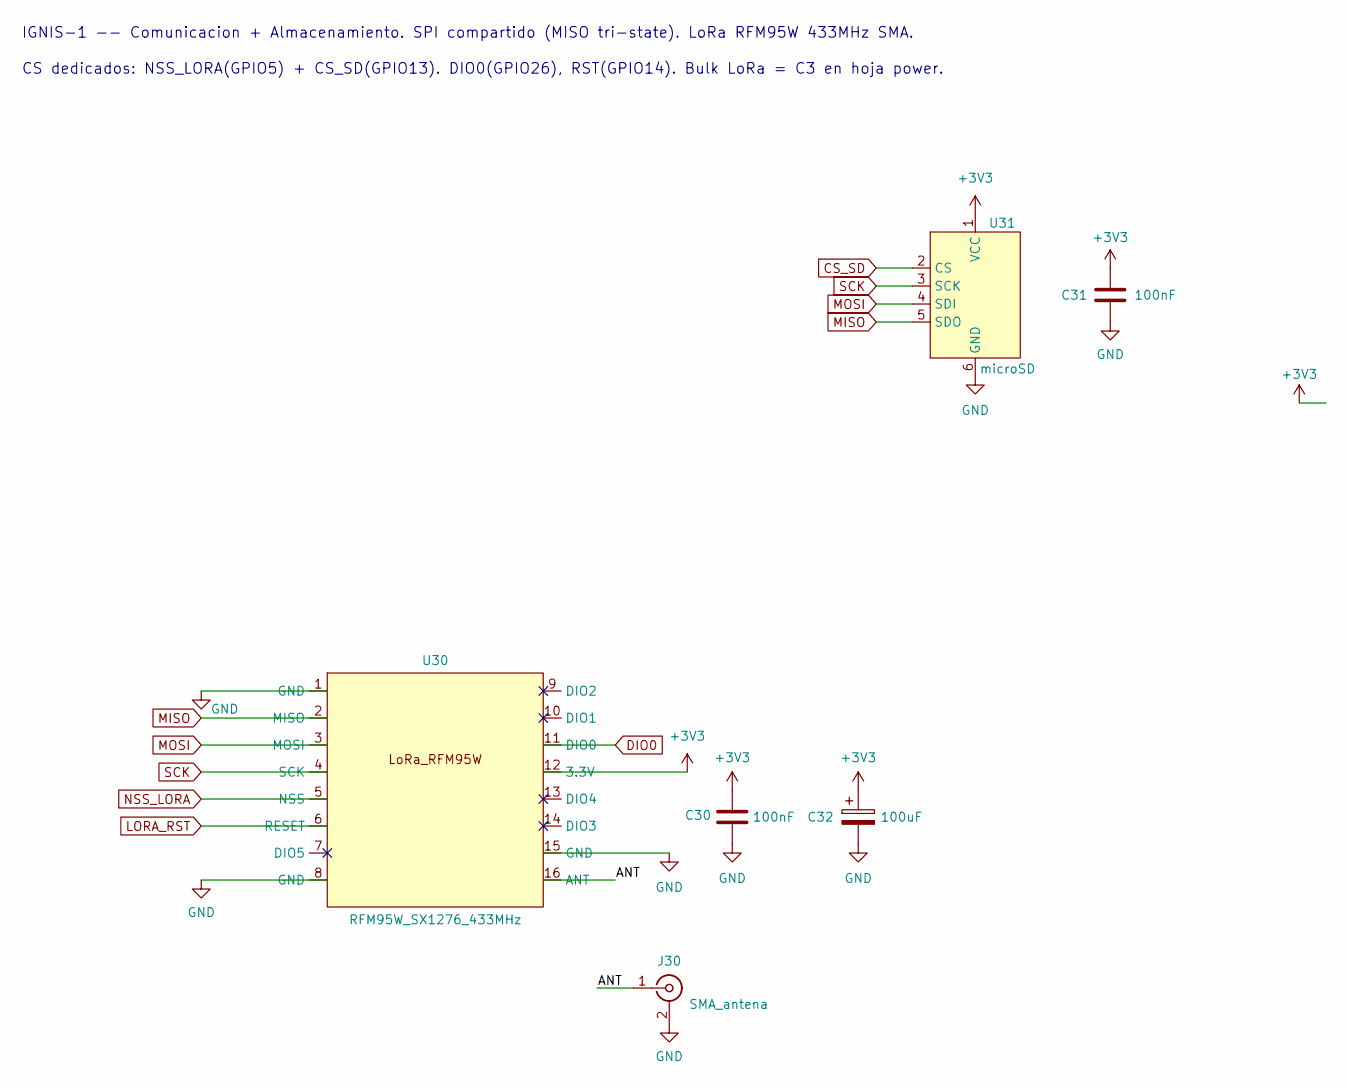
[picture p23: schematic sub_rf.kicad_sch]

Parts:
C30, C31: 100nF; C_0805_2012Metric
C32: 100uF; C_1210_3225Metric
J30: SMA_antena; SMA_Amphenol_901-144_Vertical
U30: RFM95W_SX1276_433MHz; LoRa_RFM95_adapter
U31: microSD; MicroSD_module

Connections:
+3V3: C30.1, C31.1, C32.1, U30.12 (3.3V), U31.1 (VCC); also elsewhere on the board
/rf/ANT: J30.1 (In), U30.16 (ANT)
CS_SD: U31.2 (CS); also elsewhere on the board
DIO0: U30.11 (DIO0); also elsewhere on the board
GND: C30.2, C31.2, C32.2, J30.2 (Ext), U30.1 (GND), U30.8 (GND), U30.15 (GND), U31.6 (GND); also elsewhere on the board
LORA_RST: U30.6 (RESET); also elsewhere on the board
MISO: U30.2 (MISO), U31.5 (SDO); also elsewhere on the board
MOSI: U30.3 (MOSI), U31.4 (SDI); also elsewhere on the board
NSS_LORA: U30.5 (NSS); also elsewhere on the board
SCK: U30.4 (SCK), U31.3 (SCK); also elsewhere on the board

Notes on the sheet:
IGNIS-1 -- Comunicacion + Almacenamiento. SPI compartido (MISO tri-state). LoRa RFM95W 433MHz SMA.
CS dedicados: NSS_LORA(GPIO5) + CS_SD(GPIO13). DIO0(GPIO26), RST(GPIO14). Bulk LoRa = C3 en hoja power.

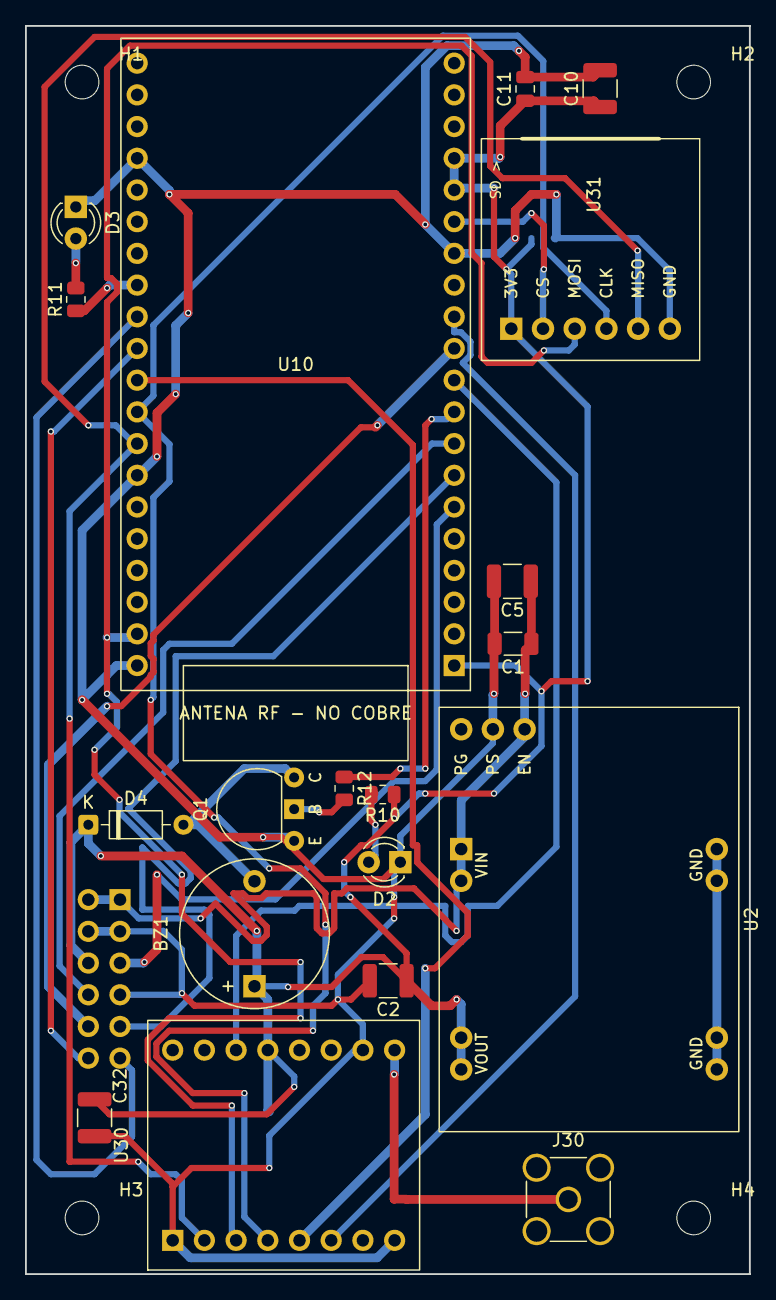
[picture p24: board placa_poder_cerebro.kicad_pcb from above]

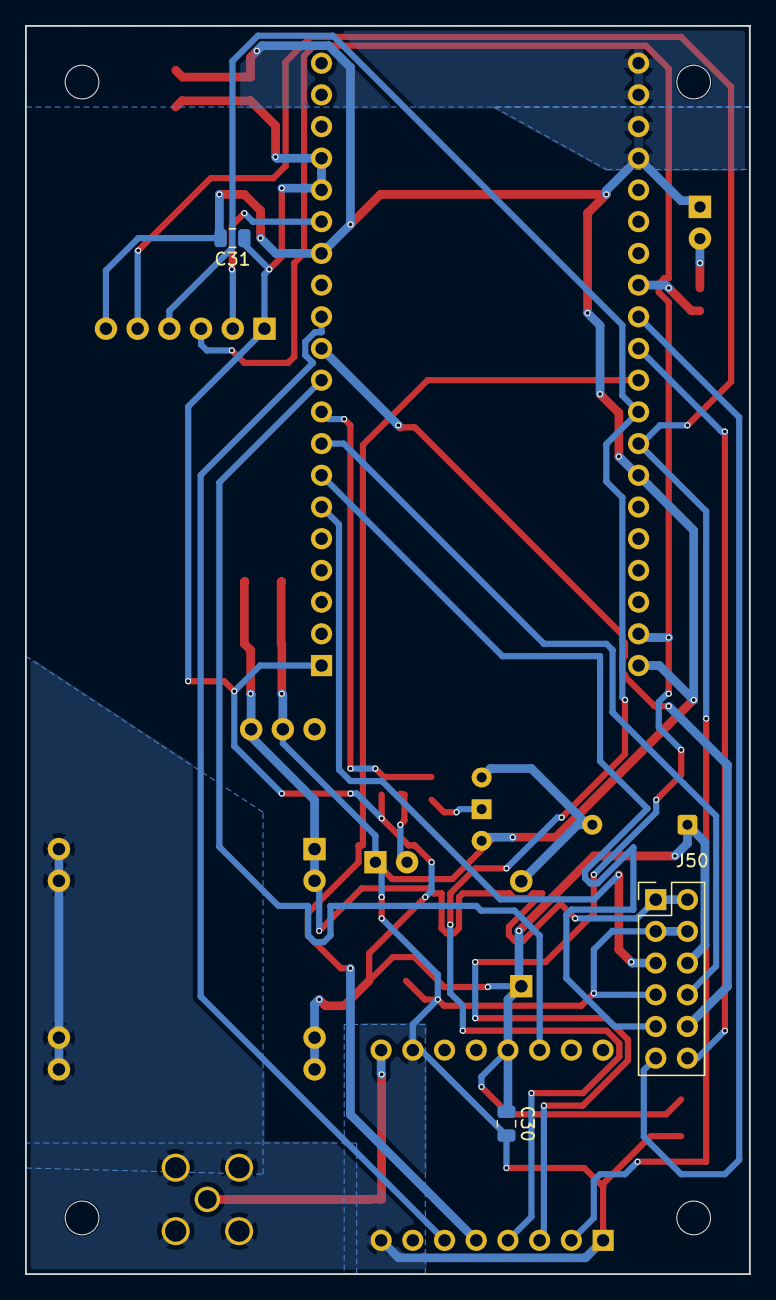
[picture p25: board placa_poder_cerebro.kicad_pcb from below]

Board: 2 copper layers, 58.0 x 100.0 mm, 26 parts (3 on the bottom side), 23 nets.

Other parts of the board:
H1, H2, H3, H4: M2.5_hole; MountingHole_2.7mm_M2.5
