Kaliux2412/Experimento_Abordo/KiCad/IGNIS-1/placa_sensores/placa_sensores.kicad_pcb

## KiCad design KiCad/IGNIS-1/placa_sensores/placa_sensores.kicad_pcb (2026-07-23)

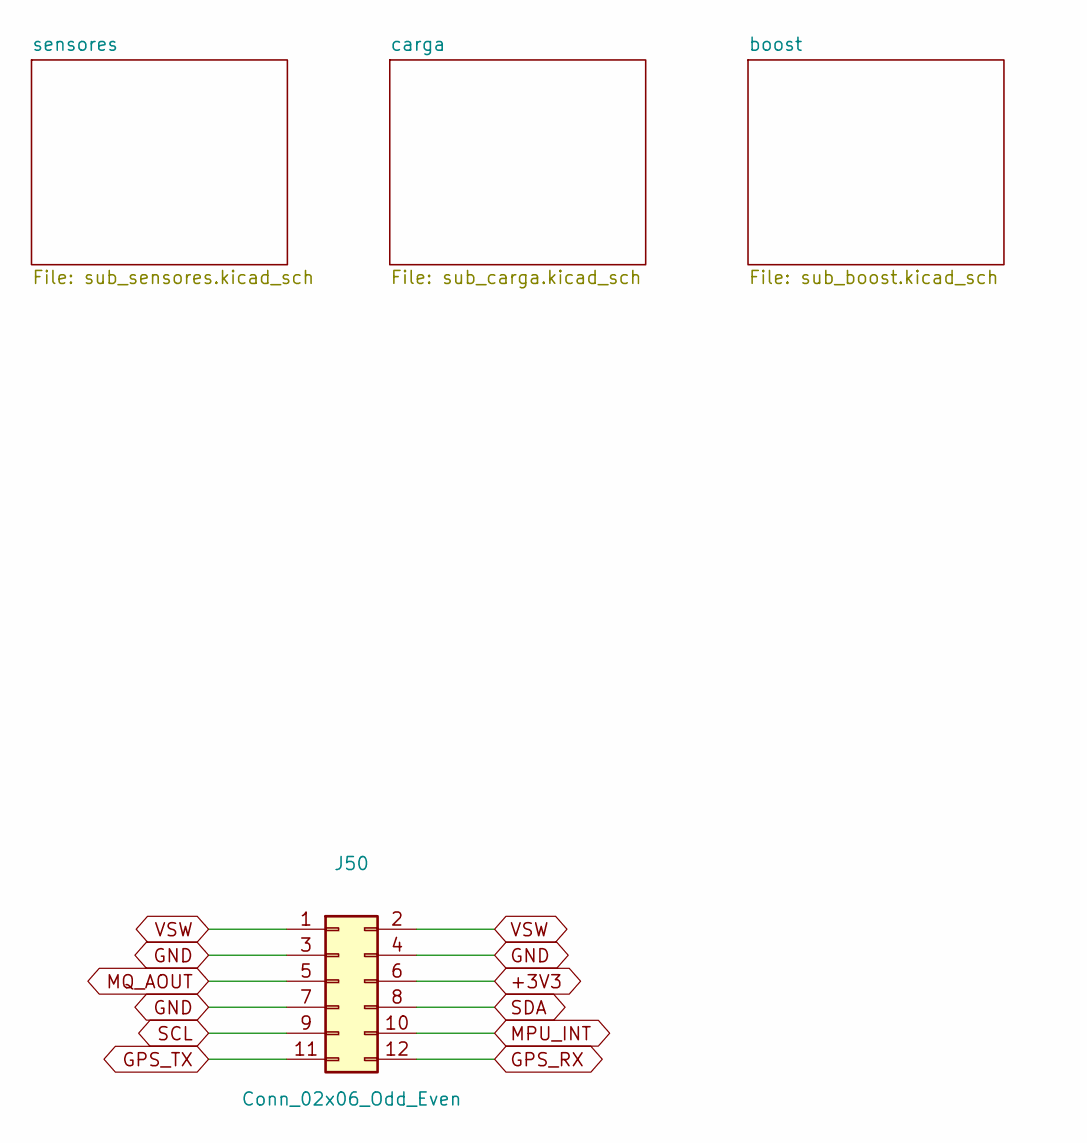
[picture p26: schematic placa_sensores.kicad_sch, IGNIS-1 Sensores]

Parts:
J50: Conn_02x06_Odd_Even; PinSocket_2x06_P2.54mm_Vertical

Connections:
+3V3: J50.6; also elsewhere on the board
GND: J50.3, J50.4, J50.7; also elsewhere on the board
GPS_RX: J50.12; also elsewhere on the board
GPS_TX: J50.11; also elsewhere on the board
MPU_INT: J50.10; also elsewhere on the board
MQ_AOUT: J50.5; also elsewhere on the board
SCL: J50.9; also elsewhere on the board
SDA: J50.8; also elsewhere on the board
VSW: J50.1, J50.2; also elsewhere on the board

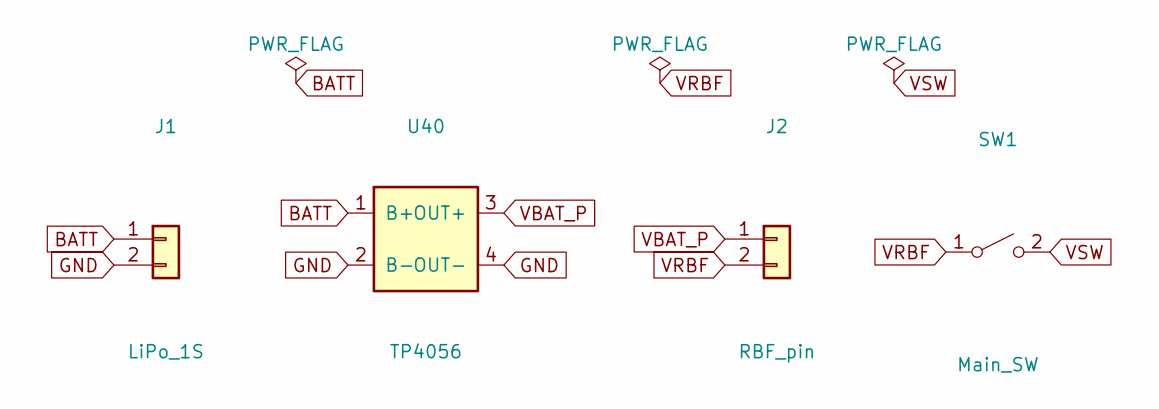
[picture p27: schematic sub_carga.kicad_sch]

Parts:
J1: LiPo_1S; JST_PH_B2B-PH-K_1x02_P2.00mm_Vertical
J2: RBF_pin; PinHeader_1x02_P2.54mm_Vertical
SW1: Main_SW; SW_Slide_SS12D00
U40: TP4056; TP4056_HW373_module

Connections:
BATT: J1.1, U40.1 (B+)
GND: J1.2, U40.2 (B-), U40.4 (OUT-); also elsewhere on the board
VBAT_P: J2.1, U40.3 (OUT+)
VRBF: J2.2, SW1.1 (A)
VSW: SW1.2 (B); also elsewhere on the board

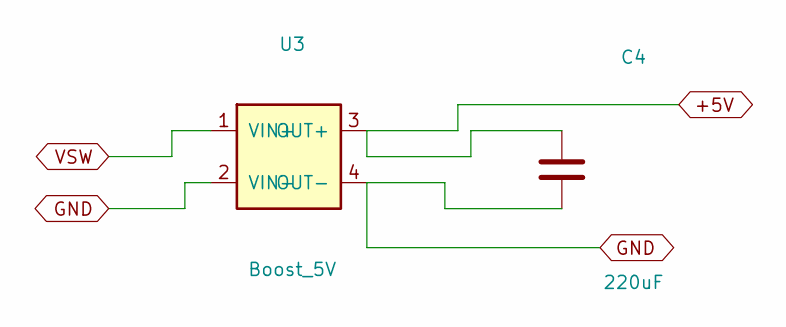
[picture p28: schematic sub_boost.kicad_sch, IGNIS-1 Boost 5V]

Parts:
C4: 220uF; CP_EIA-7343-31_Kemet-D
U3: Boost_5V; MT3608_module

Connections:
+5V: C4.1, U3.3 (OUT+); also elsewhere on the board
GND: C4.2, U3.2 (VIN-), U3.4 (OUT-); also elsewhere on the board
VSW: U3.1 (VIN+); also elsewhere on the board

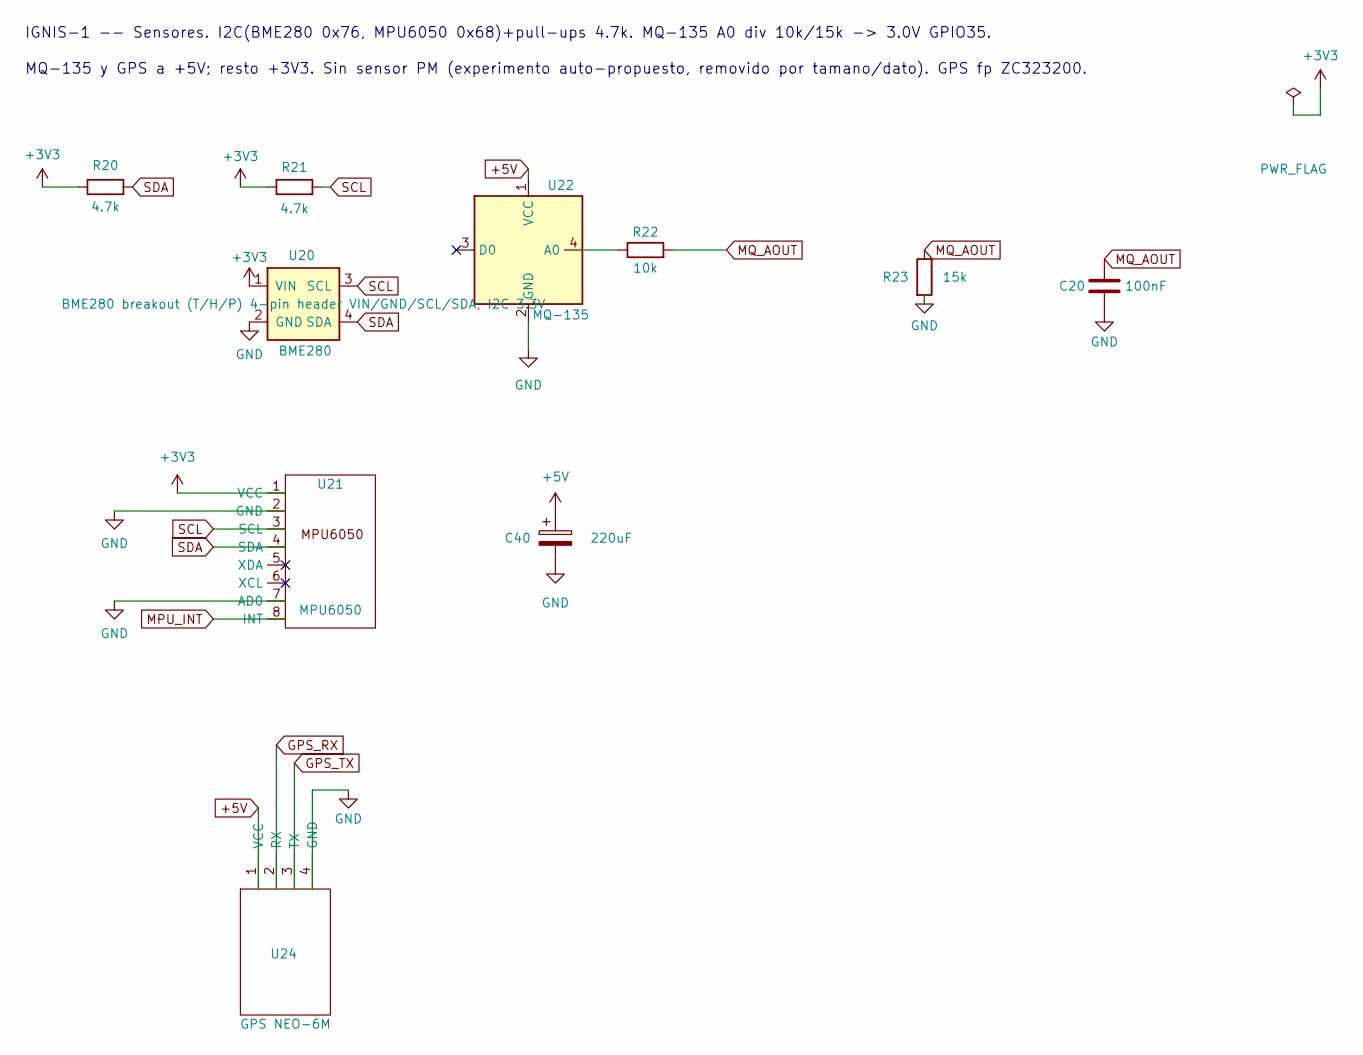
[picture p29: schematic sub_sensores.kicad_sch]

Parts:
C20: 100nF; C_0805_2012Metric
C40: 220uF; CP_EIA-7343-31_Kemet-D
R20, R21: 4.7k; R_0805_2012Metric
R22: 10k; R_0805_2012Metric
R23: 15k; R_0805_2012Metric
U20: BME280; BME280_module
U21: MPU6050; MPU6050_module
U22: MQ-135; PinHeader_1x04_P2.54mm_Vertical
U24: GPS NEO-6M; GPS_NEO6M_module

Connections:
+3V3: R20.1, R21.1, U20.1 (VIN), U21.1 (VCC); also elsewhere on the board
+5V: C40.1, U22.1 (VCC), U24.1 (VCC); also elsewhere on the board
GND: C20.2, C40.2, R23.2, U20.2 (GND), U21.2 (GND), U21.7 (AD0), U22.2 (GND), U24.4 (GND); also elsewhere on the board
GPS_RX: U24.2 (RX); also elsewhere on the board
GPS_TX: U24.3 (TX); also elsewhere on the board
MPU_INT: U21.8 (INT); also elsewhere on the board
MQ_AOUT: C20.1, R22.2, R23.1; also elsewhere on the board
unnamed: R22.1, U22.4 (A0)
SCL: R21.2, U20.3 (SCL), U21.3 (SCL); also elsewhere on the board
SDA: R20.2, U20.4 (SDA), U21.4 (SDA); also elsewhere on the board

Notes on the sheet:
IGNIS-1 -- Sensores. I2C(BME280 0x76, MPU6050 0x68)+pull-ups 4.7k. MQ-135 A0 div 10k/15k -> 3.0V GPIO35.
MQ-135 y GPS a +5V; resto +3V3. Sin sensor PM (experimento auto-propuesto, removido por tamano/dato). GPS fp ZC323200.

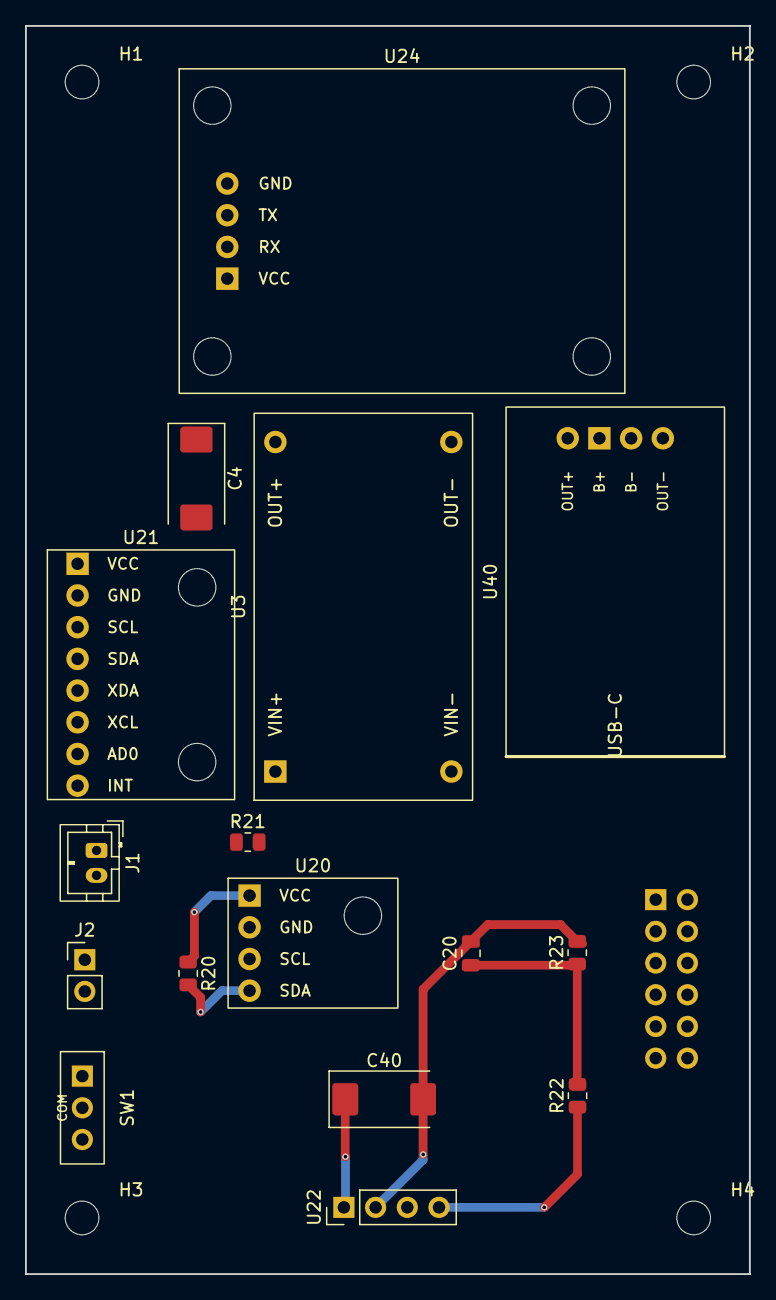
[picture p30: board placa_sensores.kicad_pcb from above]

Board: 2 copper layers, 58.0 x 100.0 mm, 21 parts (1 on the bottom side), 14 nets.

Other parts of the board:
H1, H2, H3, H4: M2.5_hole; MountingHole_2.7mm_M2.5
