Kaliux2412/Experimento_Abordo/KiCad/IGNIS-1/boards_backup_2/sensores/sensores.kicad_pcb

## KiCad design KiCad/IGNIS-1/boards_backup_2/sensores/sensores.kicad_pcb (2026-07-14)

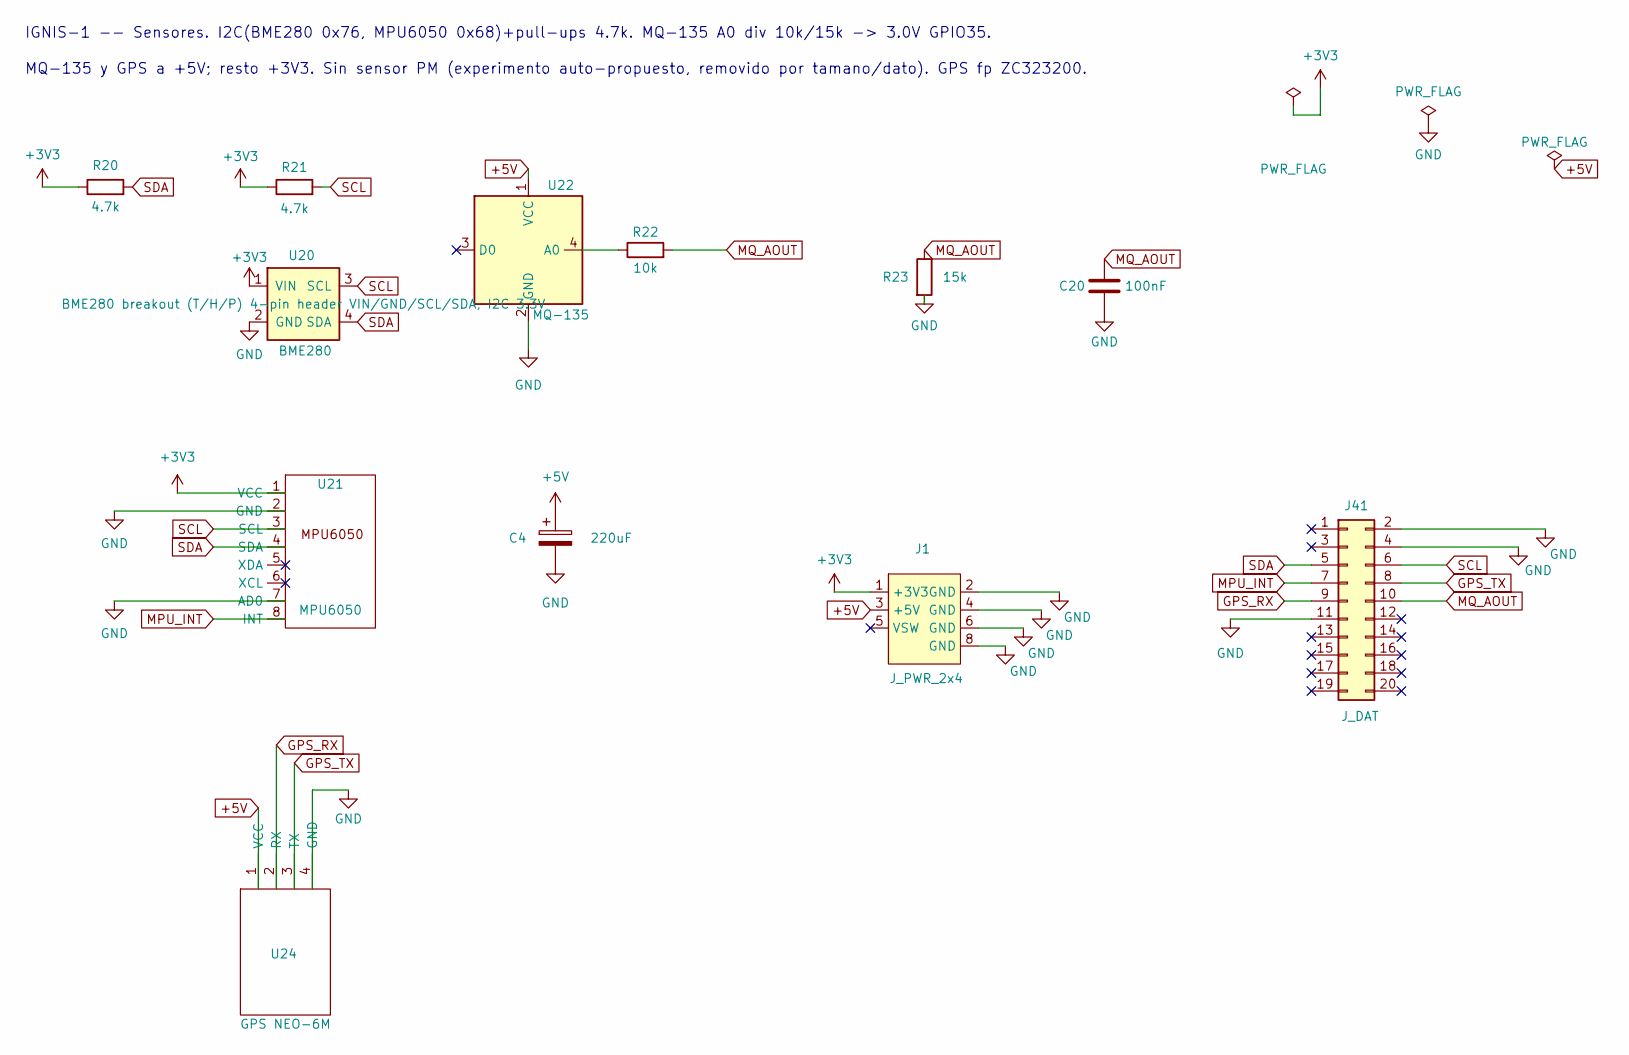
[picture p31: schematic sensores.kicad_sch]

Parts:
C4: 220uF; CP_Radial_D13.0mm_P5.00mm
C20: 100nF; C_Disc_D7.5mm_W2.5mm_P5.00mm
J1: J_PWR_2x4; J_PWR_2x4_Keyed
J41: J_DAT; PinHeader_2x10_P2.54mm_Vertical
R20, R21: 4.7k; R_Axial_DIN0207_L6.3mm_D2.5mm_P7.62mm_Horizontal
R22: 10k; R_Axial_DIN0207_L6.3mm_D2.5mm_P7.62mm_Horizontal
R23: 15k; R_Axial_DIN0207_L6.3mm_D2.5mm_P7.62mm_Horizontal
U20: BME280; PinHeader_1x04_P2.54mm_Vertical
U21: MPU6050; MPU6050_module
U22: MQ-135; PinHeader_1x04_P2.54mm_Vertical
U24: GPS NEO-6M; GPS_NEO6M_module

Connections:
+3V3: J1.1 (+3V3), R20.1, R21.1, U20.1 (VIN), U21.1 (VCC)
+5V: C4.1, J1.3 (+5V), U22.1 (VCC), U24.1 (VCC)
GND: C4.2, C20.2, J1.2 (GND), J1.4 (GND), J1.6 (GND), J1.8 (GND), J41.2, J41.4, J41.11, R23.2, U20.2 (GND), U21.2 (GND), U21.7 (AD0), U22.2 (GND), U24.4 (GND)
GPS_RX: J41.9, U24.2 (RX)
GPS_TX: J41.8, U24.3 (TX)
MPU_INT: J41.7, U21.8 (INT)
MQ_AOUT: C20.1, J41.10, R22.2, R23.1
unnamed: R22.1, U22.4 (A0)
SCL: J41.6, R21.2, U20.3 (SCL), U21.3 (SCL)
SDA: J41.5, R20.2, U20.4 (SDA), U21.4 (SDA)

Notes on the sheet:
IGNIS-1 -- Sensores. I2C(BME280 0x76, MPU6050 0x68)+pull-ups 4.7k. MQ-135 A0 div 10k/15k -> 3.0V GPIO35.
MQ-135 y GPS a +5V; resto +3V3. Sin sensor PM (experimento auto-propuesto, removido por tamano/dato). GPS fp ZC323200.

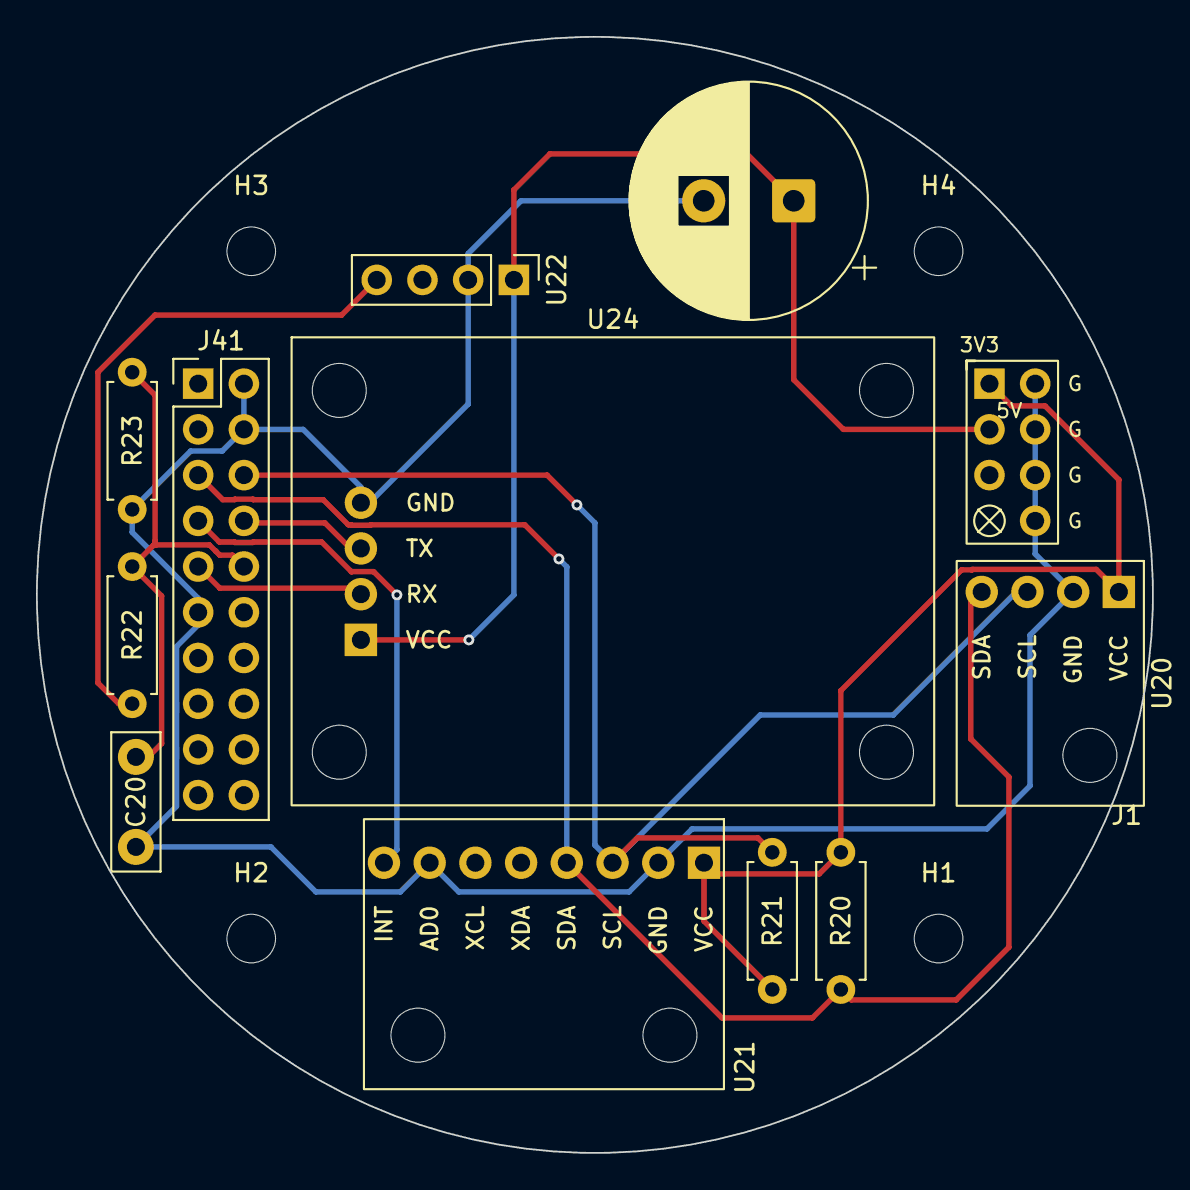
[picture p32: board sensores.kicad_pcb from above]

Board: 2 copper layers, 62.0 x 62.0 mm, 16 parts (0 on the bottom side), 10 nets.

Other parts of the board:
H1, H2, H3, H4: M2.5_hole; MountingHole_2.7mm_M2.5
