Kaliux2412/Experimento_Abordo/KiCad/IGNIS-1/boards_backup_2/cerebro/cerebro.kicad_pcb

## KiCad design KiCad/IGNIS-1/boards_backup_2/cerebro/cerebro.kicad_pcb (2026-07-14)

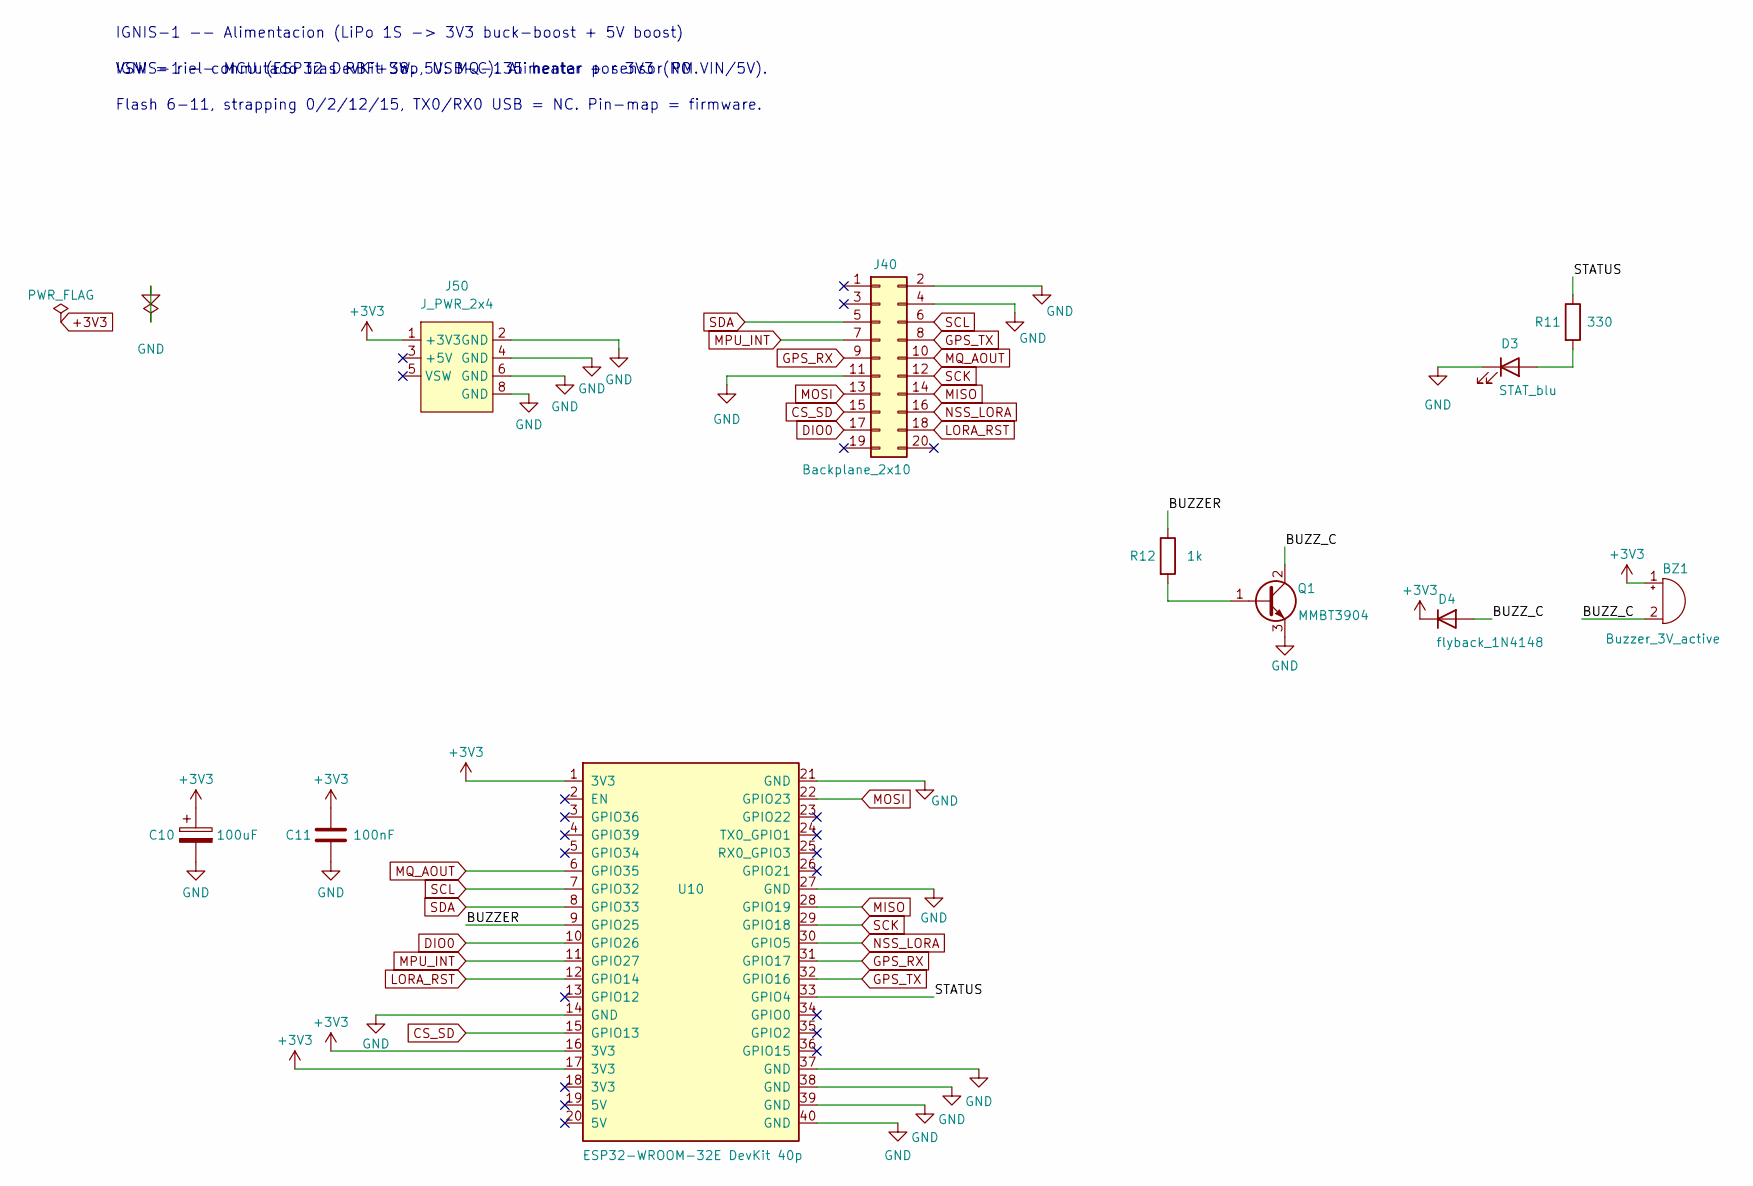
[picture p33: schematic cerebro.kicad_sch]

Parts:
BZ1: Buzzer_3V_active; Buzzer_D12_P8.41
C10: 100uF; CP_Radial_D8.0mm_P3.80mm
C11: 100nF; C_Disc_D7.5mm_W2.5mm_P5.00mm
D3: STAT_blu; LED_D3.0mm
D4: flyback_1N4148; D_DO-35_SOD27_P7.62mm_Horizontal
J40: Backplane_2x10; PinHeader_2x10_P2.54mm_Vertical
J50: J_PWR_2x4; J_PWR_2x4_Keyed
Q1: MMBT3904; Q_TO92_2N3904_EBC
R11: 330; R_Axial_DIN0207_L6.3mm_D2.5mm_P7.62mm_Horizontal
R12: 1k; R_Axial_DIN0207_L6.3mm_D2.5mm_P7.62mm_Horizontal
U10: ESP32-WROOM-32E DevKit 40p; ESP32_DevKit_40p

Connections:
+3V3: BZ1.1 (+), C10.1, C11.1, D4.1 (K), J50.1 (+3V3), U10.1 (3V3), U10.16 (3V3), U10.17 (3V3)
/BUZZER: R12.1, U10.9 (GPIO25)
/BUZZ_C: BZ1.2 (-), D4.2 (A), Q1.2 (C)
/STATUS: R11.1, U10.33 (GPIO4)
CS_SD: J40.15, U10.15 (GPIO13)
DIO0: J40.17, U10.10 (GPIO26)
GND: C10.2, C11.2, D3.1 (K), J40.2, J40.4, J40.11, J50.2 (GND), J50.4 (GND), J50.6 (GND), J50.8 (GND), Q1.3 (E), U10.14 (GND), U10.21 (GND), U10.27 (GND), U10.37 (GND), U10.38 (GND), U10.39 (GND), U10.40 (GND)
GPS_RX: J40.9, U10.31 (GPIO17)
GPS_TX: J40.8, U10.32 (GPIO16)
LORA_RST: J40.18, U10.12 (GPIO14)
MISO: J40.14, U10.28 (GPIO19)
MOSI: J40.13, U10.22 (GPIO23)
MPU_INT: J40.7, U10.11 (GPIO27)
MQ_AOUT: J40.10, U10.6 (GPIO35)
NSS_LORA: J40.16, U10.30 (GPIO5)
unnamed: D3.2 (A), R11.2
unnamed: Q1.1 (B), R12.2
SCK: J40.12, U10.29 (GPIO18)
SCL: J40.6, U10.7 (GPIO32)
SDA: J40.5, U10.8 (GPIO33)

Notes on the sheet:
VSW = riel conmutado tras RBF+SW. 5V: MQ-135 heater + sensor PM.
Flash 6-11, strapping 0/2/12/15, TX0/RX0 USB = NC. Pin-map = firmware.
IGNIS-1 -- Alimentacion (LiPo 1S -> 3V3 buck-boost + 5V boost)
IGNIS-1 -- MCU (ESP32 DevKit 38p, USB-C). Alimentar por 3V3 (NO VIN/5V).
