Kaliux2412/Experimento_Abordo/KiCad/IGNIS-1/boards_backup_2/cerebro/cerebro.kicad_pcb

## KiCad design KiCad/IGNIS-1/boards_backup_2/cerebro/cerebro.kicad_pcb (continued)

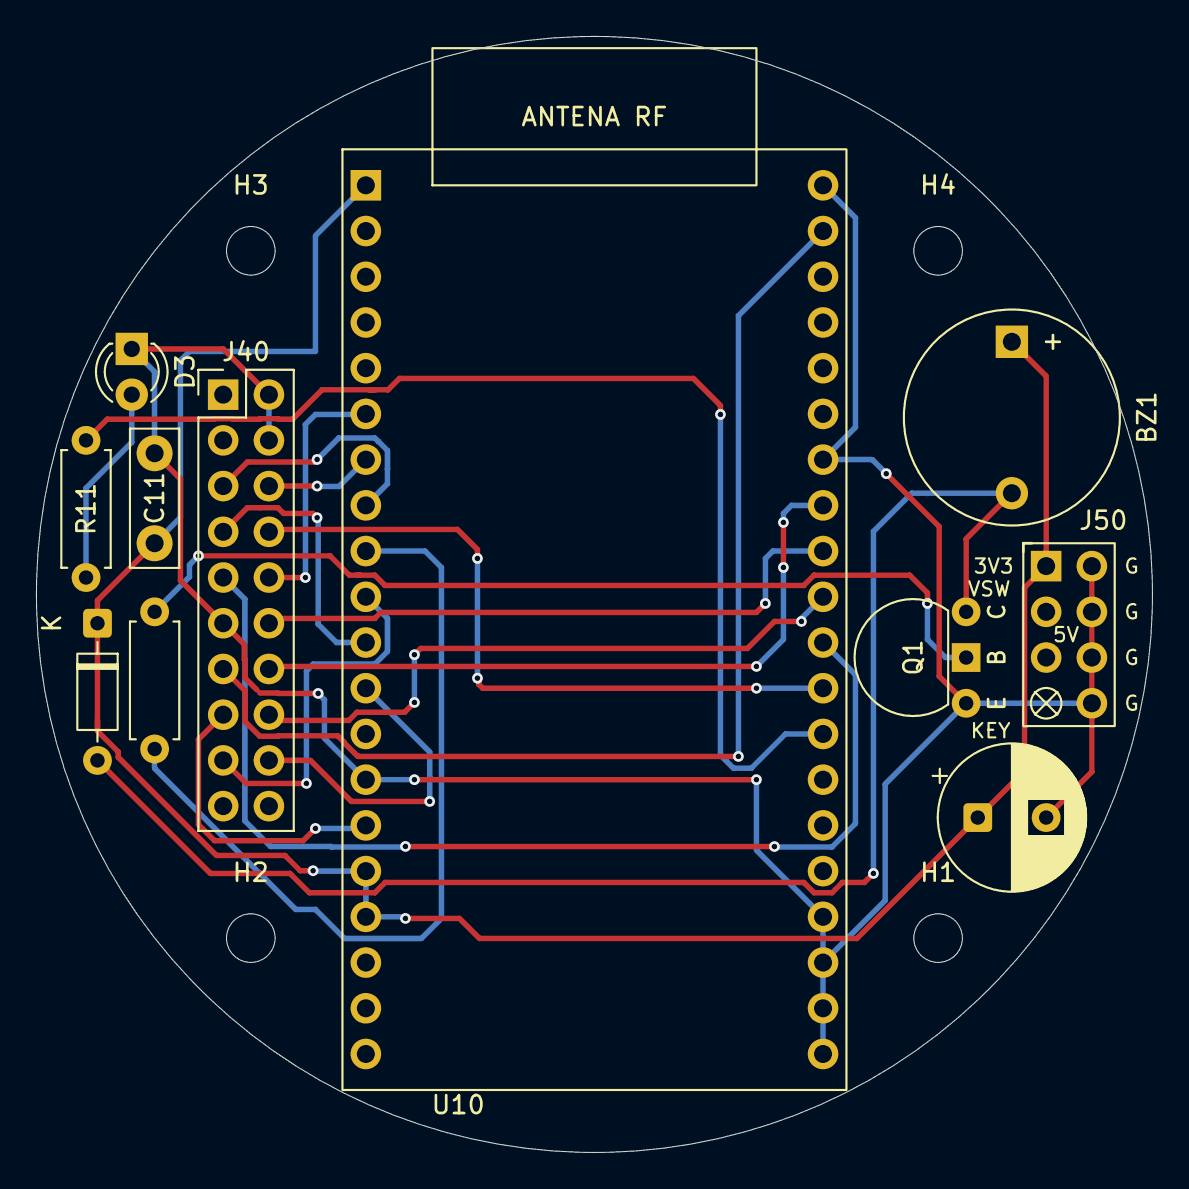
[picture p34: board cerebro.kicad_pcb from above]

Board: 2 copper layers, 62.0 x 62.0 mm, 15 parts (0 on the bottom side), 20 nets.

Other parts of the board:
H1, H2, H3, H4: M2.5_hole; MountingHole_2.7mm_M2.5
