Kaliux2412/Experimento_Abordo/KiCad/IGNIS-1/boards_backup_2/energia/energia.kicad_pcb

## KiCad design KiCad/IGNIS-1/boards_backup_2/energia/energia.kicad_pcb (2026-07-14)

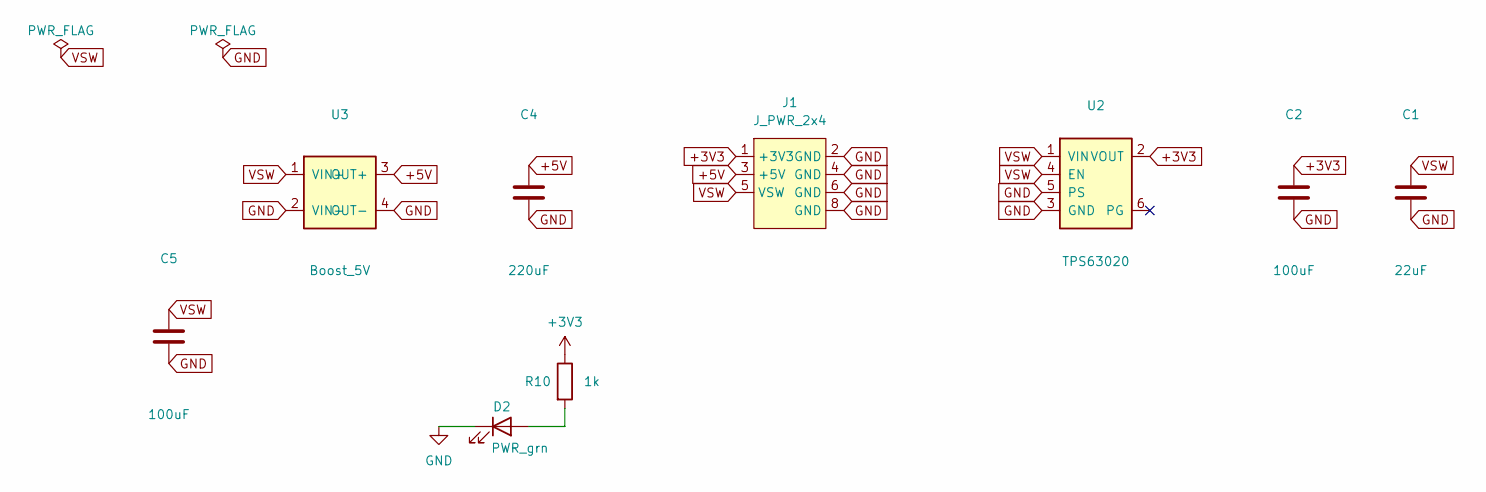
[picture p35: schematic energia.kicad_sch]

Parts:
C1: 22uF; CP_Radial_D6.3mm_P2.50mm
C2, C5: 100uF; CP_Radial_D8.0mm_P3.80mm
C4: 220uF; CP_Radial_D13.0mm_P5.00mm
D2: PWR_grn; LED_D3.0mm
J1: J_PWR_2x4; J_PWR_2x4_Keyed
R10: 1k; R_Axial_DIN0207_L6.3mm_D2.5mm_P7.62mm_Horizontal
U2: TPS63020; TPS63020_module
U3: Boost_5V; MT3608_module

Connections:
+3V3: C2.1, J1.1 (+3V3), R10.1, U2.2 (VOUT)
+5V: C4.1, J1.3 (+5V), U3.3 (OUT+)
GND: C1.2, C2.2, C4.2, C5.2, D2.1 (K), J1.2 (GND), J1.4 (GND), J1.6 (GND), J1.8 (GND), U2.3 (GND), U2.5 (PS), U3.2 (VIN-), U3.4 (OUT-)
unnamed: D2.2 (A), R10.2
VSW: C1.1, C5.1, J1.5 (VSW), U2.1 (VIN), U2.4 (EN), U3.1 (VIN+)

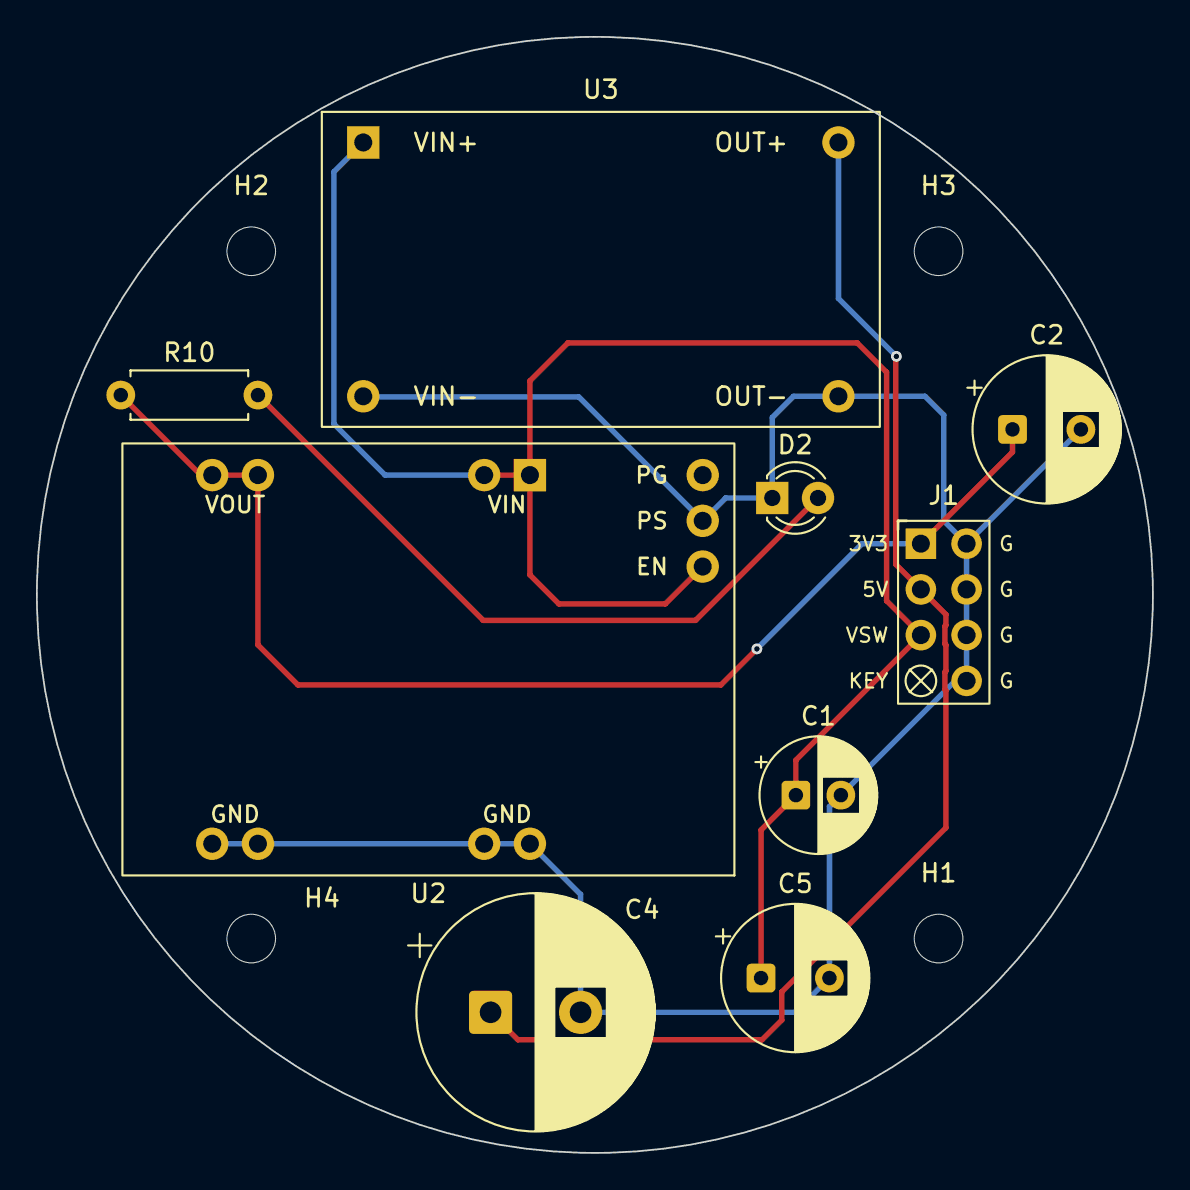
[picture p36: board energia.kicad_pcb from above]

Board: 2 copper layers, 62.0 x 62.0 mm, 13 parts (0 on the bottom side), 5 nets.

Other parts of the board:
H1, H2, H3, H4: M2.5_hole; MountingHole_2.7mm_M2.5
