Kaliux2412/Experimento_Abordo/KiCad/IGNIS-1/boards_backup_2/rf/rf.kicad_pcb

## KiCad design KiCad/IGNIS-1/boards_backup_2/rf/rf.kicad_pcb (2026-07-14)

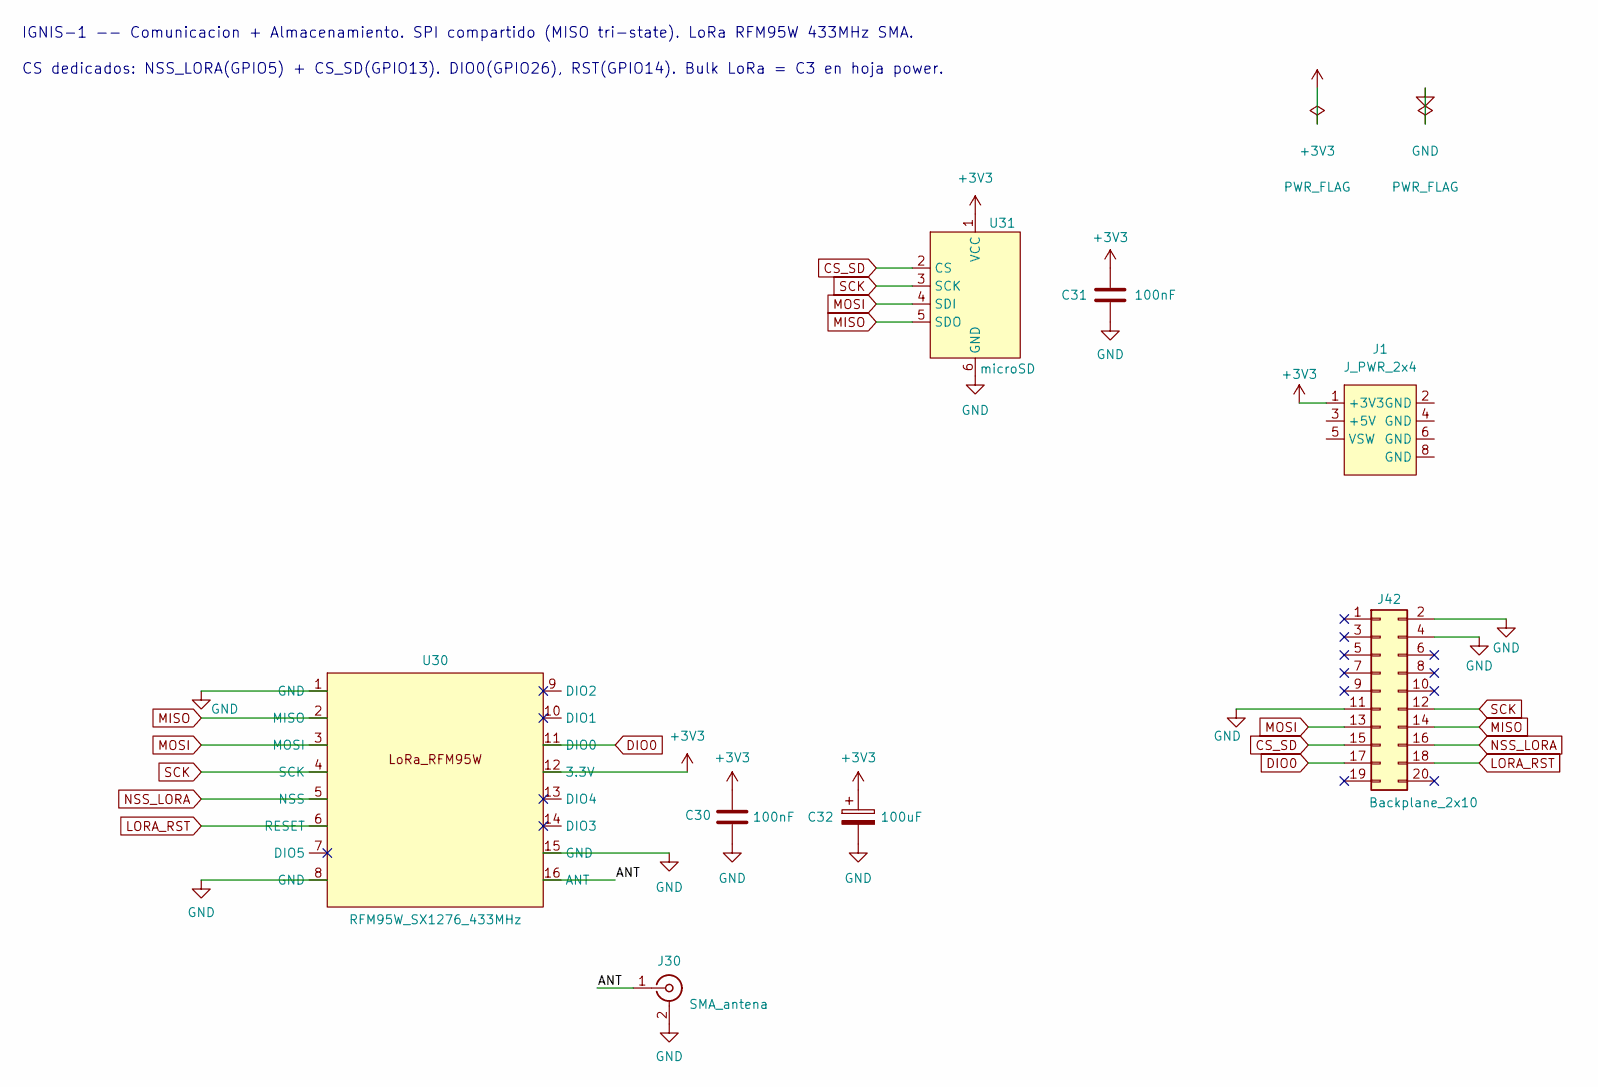
[picture p37: schematic rf.kicad_sch]

Parts:
C30, C31: 100nF; C_Disc_D7.5mm_W2.5mm_P5.00mm
C32: 100uF; CP_Radial_D8.0mm_P3.80mm
J1: J_PWR_2x4; J_PWR_2x4_Keyed
J30: SMA_antena; SMA_Amphenol_901-144_Vertical
J42: Backplane_2x10; PinHeader_2x10_P2.54mm_Vertical
U30: RFM95W_SX1276_433MHz; LoRa_RFM95_adapter
U31: microSD; PinHeader_1x06_P2.54mm_Vertical

Connections:
+3V3: C30.1, C31.1, C32.1, J1.1 (+3V3_1), U30.12 (3.3V), U31.1 (VCC)
/ANT: J30.1 (In), U30.16 (ANT)
CS_SD: J42.15, U31.2 (CS)
DIO0: J42.17, U30.11 (DIO0)
GND: C30.2, C31.2, C32.2, J30.2 (Ext), J42.2, J42.4, J42.11, U30.1 (GND), U30.8 (GND), U30.15 (GND), U31.6 (GND)
LORA_RST: J42.18, U30.6 (RESET)
MISO: J42.14, U30.2 (MISO), U31.5 (SDO)
MOSI: J42.13, U30.3 (MOSI), U31.4 (SDI)
NSS_LORA: J42.16, U30.5 (NSS)
SCK: J42.12, U30.4 (SCK), U31.3 (SCK)

Notes on the sheet:
IGNIS-1 -- Comunicacion + Almacenamiento. SPI compartido (MISO tri-state). LoRa RFM95W 433MHz SMA.
CS dedicados: NSS_LORA(GPIO5) + CS_SD(GPIO13). DIO0(GPIO26), RST(GPIO14). Bulk LoRa = C3 en hoja power.

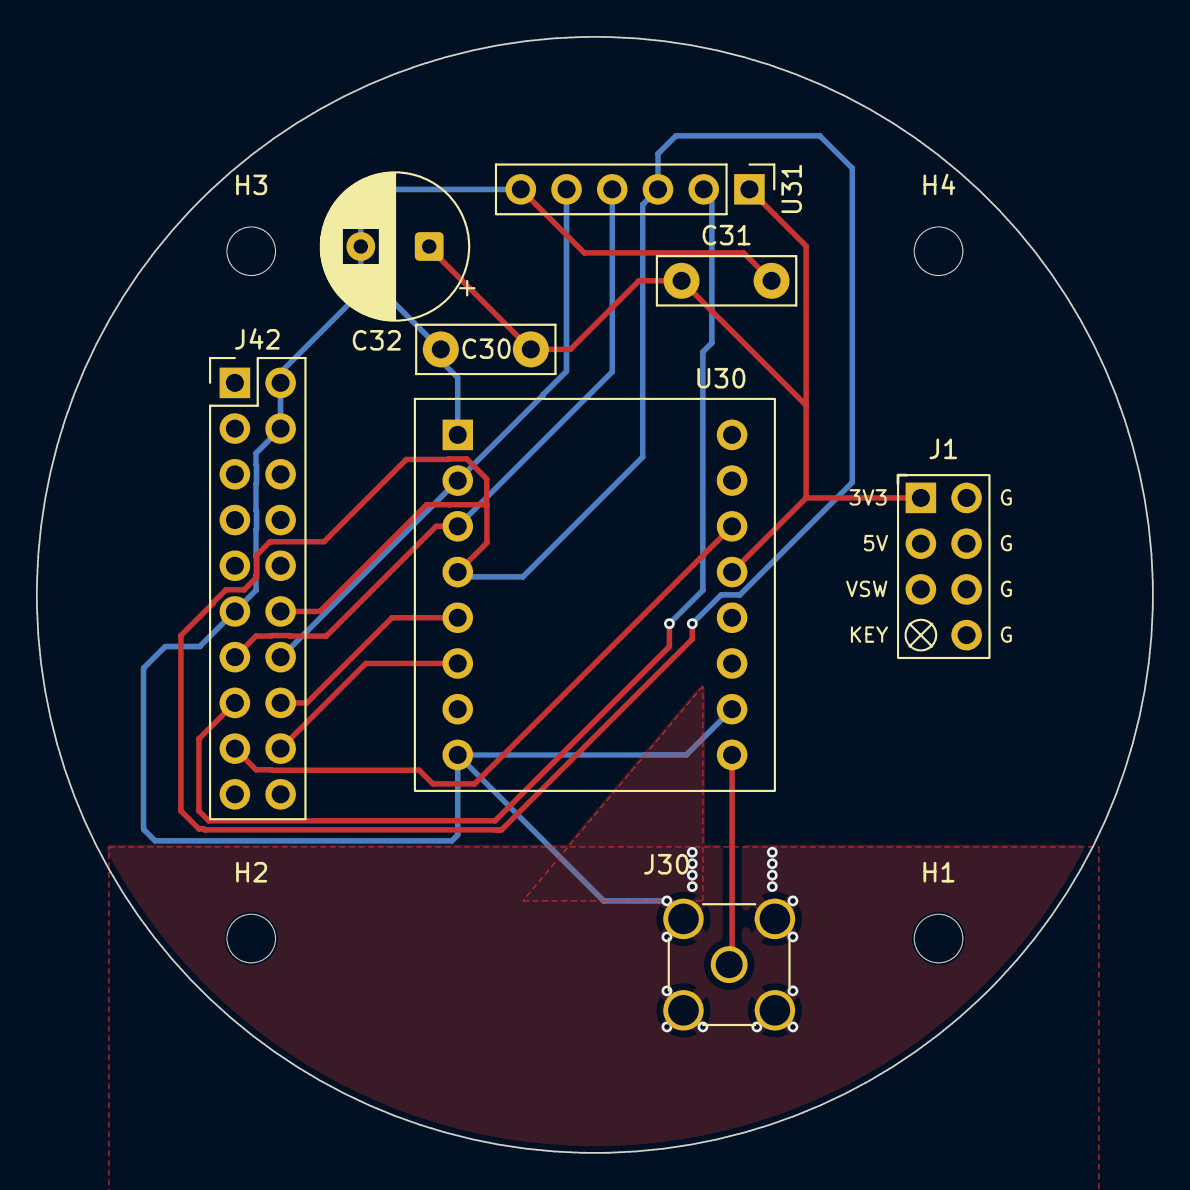
[picture p38: board rf.kicad_pcb from above]

Board: 2 copper layers, 62.0 x 62.0 mm, 12 parts (0 on the bottom side), 10 nets.

Other parts of the board:
H1, H2, H3, H4: M2.5_hole; MountingHole_2.7mm_M2.5
