Kaliux2412/Experimento_Abordo/KiCad/Project/Schema_Experimento_Abordo.kicad_pcb

## KiCad design KiCad/Project/Schema_Experimento_Abordo.kicad_pcb (2026-06-23)

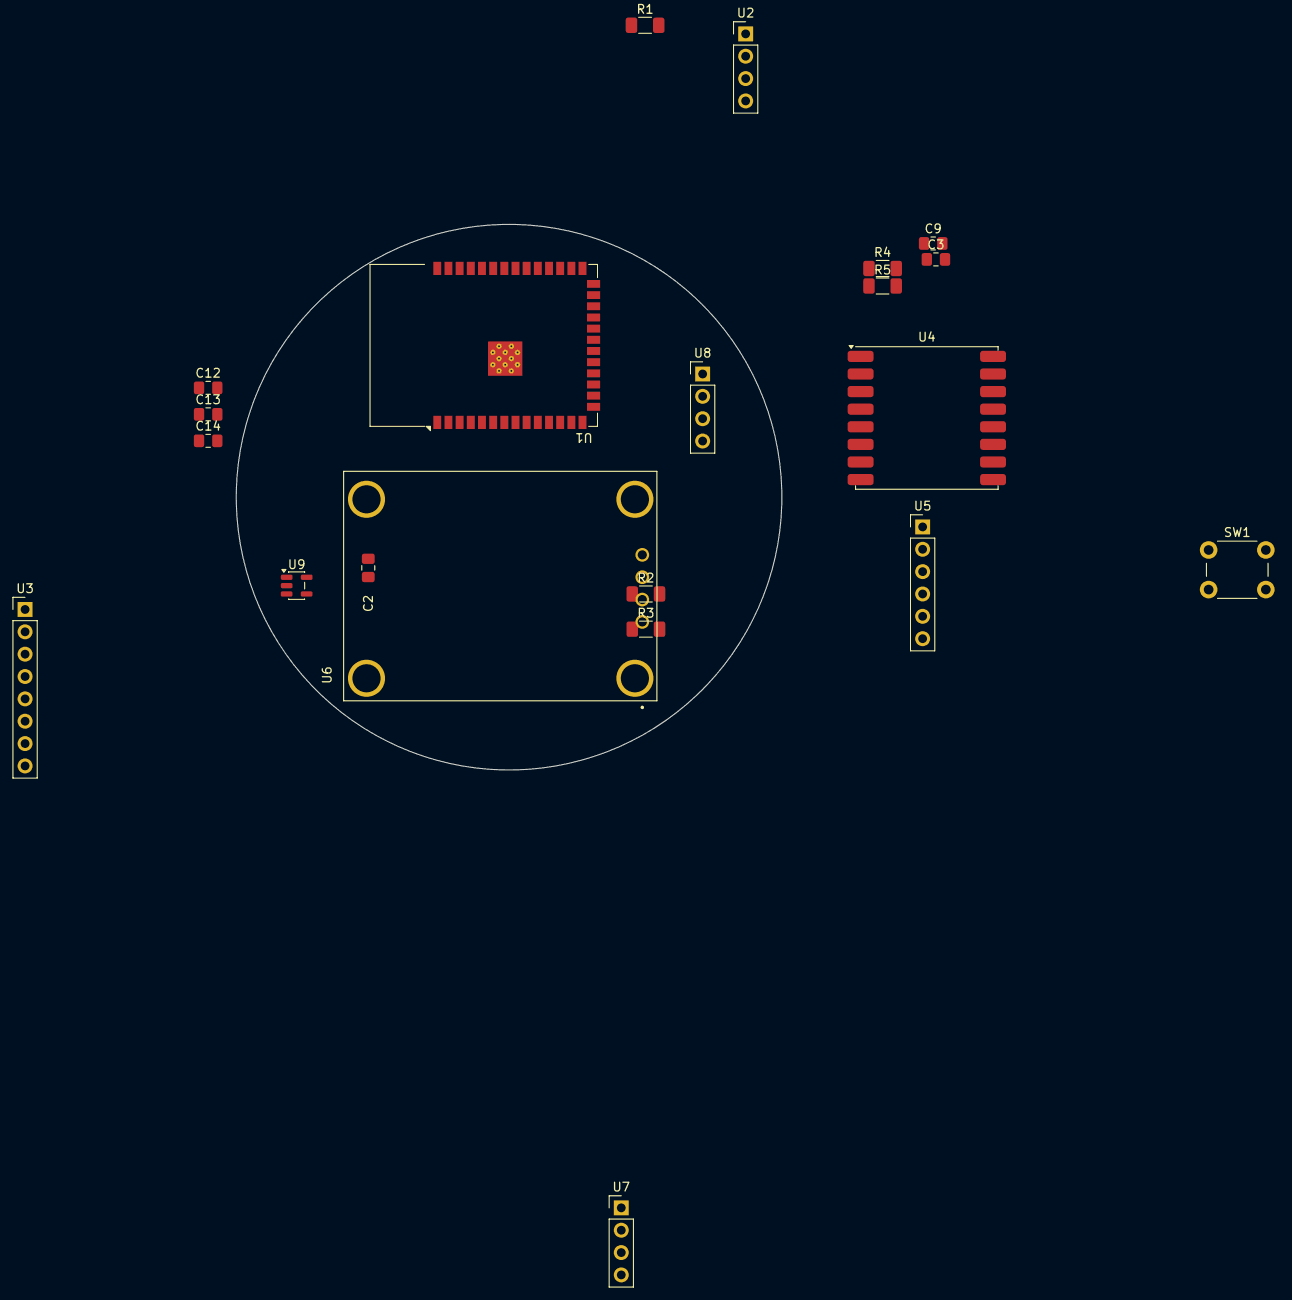
[picture p39: board Schema_Experimento_Abordo.kicad_pcb from above]

Board: 2 copper layers, 62.0 x 62.0 mm, 21 parts (0 on the bottom side), 17 nets, no tracks yet.

Parts:
C2, C9, C12, C13: 10uF; C_0805_2012Metric_Pad1.18x1.45mm_HandSolder
C3: 0.1uF; C_0805_2012Metric_Pad1.18x1.45mm_HandSolder
C14: 100nF; C_0805_2012Metric_Pad1.18x1.45mm_HandSolder
R1: 10k; R_1206_3216Metric_Pad1.30x1.75mm_HandSolder
R2, R3: 4.7k; R_1206_3216Metric_Pad1.30x1.75mm_HandSolder
R4, R5: 100k; R_1206_3216Metric_Pad1.30x1.75mm_HandSolder
SW1: RESET; SW_PUSH_6mm_H4.3mm
U1: ESP32-S3-WROOM-1
U2: BME280; PinHeader_1x04_P2.54mm_Vertical
U3: PinHeader_1x08_P2.54mm_Vertical
U4: HOPERF_RFM9XW_SMD
U5: Micro_SD; PinHeader_1x06_P2.54mm_Vertical
U6: ZC323200; XCVR_ZC323200
U7: SGP30; PinHeader_1x04_P2.54mm_Vertical
U8: PinHeader_1x04_P2.54mm_Vertical
U9: AP2112K-3.3; SOT-23-5

Connections:
+3.3V: C2.1, C9.1, C13.1, C14.1, R1.2, R2.2, R3.2, U1.1 (3V3), U1.16 (VIN), U2.1 (VIN), U3.1 (VCC), U4.12 (3.3V), U5.1 (VCC), U6.1 (VCC), U7.1 (VIN), U8.1 (VIN), U9.5 (VOUT)
+BATT: C12.1, R5.1, U9.1 (VIN), U9.3 (EN)
/CS MicroSD: U1.18 (D13), U5.2 (CS)
/DIO0 LoRa: U1.22 (D26), U4.11 (DIO0)
/GPS_RX: U1.7 (TX2), U6.2 (RX)
/GPS_TX: U1.6 (RX2), U6.3 (TX)
/MISO SPI: U1.10 (D19), U4.2 (MISO), U5.5 (MISO)
/MOSI SPI: U1.15 (D23), U4.3 (MOSI), U5.3 (MOSI)
/MPU6050 INT: U1.21 (D27), U3.8 (INT)
/NSS LoRa: U1.8 (D5), U4.5 (NSS)
/RST LoRa: U1.20 (D14), U4.6 (RESET)
/SCK SPI: U1.9 (D18), U4.4 (SCK), U5.4 (CLK)
/SCL: R3.1, U1.25 (D32), U2.3 (SCL), U3.3 (SCL), U7.3 (SCL), U8.3 (SCL)
/SDA: R2.1, U1.24 (D33), U2.4 (SDA), U3.4 (SDA), U7.4 (SDA), U8.4 (SDA)
GND: C2.2, C3.2, C9.2, C12.2, C13.2, C14.2, R4.1, SW1.1, U1.2 (GND), U1.17 (GND), U1.40 (GND), U1.41 (GND), U2.2 (GND), U3.2 (GND), U3.7 (AD0), U4.1 (GND), U5.6 (GND), U6.4 (GND), U6.SH1 (GND), U6.SH2 (GND), U6.SH3 (GND), U6.SH4 (GND), U7.2 (GND), U8.2 (GND), U9.2 (GND)
unnamed: R4.2, R5.2, U1.27 (D34)
unnamed: C3.1, R1.1, SW1.2, U1.30 (EN)
