Kaliux2412/Experimento_Abordo/Firmware/Test_Protoboard/Test_Protoboard.ino

/*
 * IGNIS-1 — Test de protoboard (bring-up de hardware)
 * --------------------------------------------------------------
 * NO es el firmware de vuelo. Solo verifica que cada periferico
 * responde, con el pin-map del diseno. Cada subsistema imprime
 * PASS/FAIL y se puede desactivar si el modulo no esta conectado.
 *
 * Pin-map (ESP32 DevKit 38p):
 *   I2C  SDA/SCL ......... 33 / 32   (BME280 0x76, MPU6050 0x68)
 *   SPI  SCK/MISO/MOSI ... 18 / 19 / 23   (LoRa + microSD, CS separados)
 *   LoRa CS/RST/DIO0 ..... 5 / 14 / 26   (RFM95W 433 MHz)
 *   microSD CS ........... 13
 *   MPU_INT .............. 27
 *   Buzzer ............... 25   (activo)
 *   LED status ........... 4
 *   GPS  RX2/TX2 ......... 16 / 17   (NEO-6M, 9600 baud)
 *   MQ-135 A0 ............ 35   (ADC1, via divisor 10k/15k)
 *
 * Librerias (Library Manager):
 *   Adafruit BME280, Adafruit MPU6050, Adafruit Unified Sensor,
 *   TinyGPSPlus, LoRa (Sandeep Mistry), SD (incluida).
 *
 * Notas:
 *   - MQ-135 necesita calentamiento (varios minutos); valores
 *     inestables al inicio. El divisor 10k/15k baja A0 (0-5V) a ~0-3V.
 *   - Alimentar MQ-135 y GPS a 5V; ESP/sensores I2C a 3.3V.
 */

#include <Wire.h>
#include <SPI.h>
#include <Adafruit_Sensor.h>
#include <Adafruit_BME280.h>
#include <Adafruit_MPU6050.h>
#include <TinyGPSPlus.h>
#include <SD.h>
#include <LoRa.h>

// ---------- activar/desactivar pruebas ----------
#define TEST_BME280   1
#define TEST_MPU6050  1
#define TEST_MQ135    1
#define TEST_GPS      1
#define TEST_SD       0   // sin modulo microSD (no comprado aun)
#define TEST_LORA     0   // sin modulo RFM95W (no comprado aun)

// ---------- pines ----------
#define I2C_SDA   33
#define I2C_SCL   32
#define SPI_SCK   18
#define SPI_MISO  19
#define SPI_MOSI  23
#define LORA_CS    5
#define LORA_RST  14
#define LORA_DIO0 26
#define SD_CS     13
#define MPU_INT   27
#define BUZZER    25
#define LED       4
#define GPS_RX    16    // ESP RX2 <- GPS TX
#define GPS_TX    17    // ESP TX2 -> GPS RX
#define MQ_AOUT   35    // ADC1 (input-only)
#define LORA_FREQ 433E6

// divisor MQ-135: A0 --[10k]--+--[15k]-- GND ; tap = ADC
const float MQ_DIV = (10.0 + 15.0) / 15.0;   // factor inverso = 1.667

Adafruit_BME280 bme;
Adafruit_MPU6050 mpu;
TinyGPSPlus gps;

bool okBME=false, okMPU=false, okSD=false, okLoRa=false;
uint32_t seq=0;

// ---------- offsets de calibracion MPU6050 ----------
// Se calculan en reposo al boot. Accel: se asume placa plana, Z arriba
// (az debe quedar ~9.81 m/s2, ax/ay ~0). Gyro: los tres ejes ~0 rad/s.
const float G0 = 9.80665;          // gravedad estandar (m/s2)
float axOff=0, ayOff=0, azOff=0;   // bias accel (m/s2)
float gxOff=0, gyOff=0, gzOff=0;   // bias gyro (rad/s)

void beep(int ms){ digitalWrite(BUZZER,HIGH); delay(ms); digitalWrite(BUZZER,LOW); }
void line(){ Serial.println(F("------------------------------------------")); }

void i2cScan(){
  Serial.println(F("[I2C] scan:"));
  int n=0;
  for(uint8_t a=1;a<127;a++){
    Wire.beginTransmission(a);
    if(Wire.endTransmission()==0){
      Serial.printf("   0x%02X", a);
      if(a==0x76||a==0x77) Serial.print(F(" (BME280)"));
      if(a==0x68||a==0x69) Serial.print(F(" (MPU6050)"));
      Serial.println();
      n++;
    }
  }
  Serial.printf("   %d dispositivo(s)\n", n);
}

#if TEST_MPU6050
// Promedia N muestras en reposo y calcula los offsets.
// IMPORTANTE: la placa debe estar quieta y plana durante la calibracion.
void calibrarMPU(int n=1000){
  Serial.printf("[MPU6050] calibrando (%d muestras, no mover)...\n", n);
  double sax=0,say=0,saz=0, sgx=0,sgy=0,sgz=0;
  sensors_event_t a,g,tmp;
  for(int i=0;i<n;i++){
    mpu.getEvent(&a,&g,&tmp);
    sax+=a.acceleration.x; say+=a.acceleration.y; saz+=a.acceleration.z;
    sgx+=g.gyro.x;         sgy+=g.gyro.y;         sgz+=g.gyro.z;
    delay(2);
  }
  axOff = sax/n;           // en reposo plano ax~0 -> todo es bias
  ayOff = say/n;           // ay~0 -> todo es bias
  azOff = saz/n - G0;      // az debe ser G0; el exceso es bias
  gxOff = sgx/n;           // gyro en reposo ~0 -> todo es bias
  gyOff = sgy/n;
  gzOff = sgz/n;
  Serial.printf("[MPU6050] offset accel: ax=%.3f ay=%.3f az=%.3f m/s2\n", axOff, ayOff, azOff);
  Serial.printf("[MPU6050] offset gyro:  gx=%.4f gy=%.4f gz=%.4f rad/s\n", gxOff, gyOff, gzOff);
}
#endif

void setup(){
  Serial.begin(115200);
  delay(500);
  pinMode(LED, OUTPUT);
  pinMode(BUZZER, OUTPUT);
  pinMode(MPU_INT, INPUT);
  digitalWrite(LED,HIGH); beep(120); digitalWrite(LED,LOW);

  line();
  Serial.println(F("IGNIS-1 — Test de protoboard"));
  line();

  Wire.begin(I2C_SDA, I2C_SCL);
  i2cScan();

#if TEST_BME280
  okBME = bme.begin(0x76) || bme.begin(0x77);
  Serial.printf("[BME280]  %s\n", okBME ? "PASS" : "FAIL (revisar I2C/dir)");
#endif

#if TEST_MPU6050
  okMPU = mpu.begin(0x68);
  if(okMPU){
    mpu.setAccelerometerRange(MPU6050_RANGE_8_G);
    mpu.setGyroRange(MPU6050_RANGE_500_DEG);
    mpu.setFilterBandwidth(MPU6050_BAND_21_HZ);   // filtra ruido antes de calibrar
  }
  Serial.printf("[MPU6050] %s\n", okMPU ? "PASS" : "FAIL");
  if(okMPU) calibrarMPU();
#endif

#if TEST_MQ135
  analogReadResolution(12);
  analogSetPinAttenuation(MQ_AOUT, ADC_11db);   // rango ~0-3.1V
  Serial.println(F("[MQ-135]  ADC listo (necesita warmup)"));
#endif

#if TEST_GPS
  Serial2.begin(9600, SERIAL_8N1, GPS_RX, GPS_TX);
  Serial.println(F("[GPS]     UART2 abierto (esperando NMEA)"));
#endif

#if (TEST_SD || TEST_LORA)
  SPI.begin(SPI_SCK, SPI_MISO, SPI_MOSI);
#endif

#if TEST_SD
  okSD = SD.begin(SD_CS, SPI);
  Serial.printf("[microSD] %s\n", okSD ? "PASS" : "FAIL");
  if(okSD){
    File f = SD.open("/test.txt", FILE_APPEND);
    if(f){ f.println("IGNIS-1 test boot"); f.close(); Serial.println(F("   escribio /test.txt")); }
  }
#endif

#if TEST_LORA
  LoRa.setPins(LORA_CS, LORA_RST, LORA_DIO0);
  okLoRa = LoRa.begin(LORA_FREQ);
  if(okLoRa) LoRa.setSyncWord(0x12);
  Serial.printf("[LoRa]    %s (433 MHz)\n", okLoRa ? "PASS" : "FAIL");
#endif

  line();
  Serial.println(F("Loop: lecturas cada 2 s"));
  line();
  if(okBME && okMPU){ beep(60); delay(60); beep(60); }  // doble beep = sensores I2C OK
}

void loop(){
  digitalWrite(LED, !digitalRead(LED));   // latido

  // alimentar parser GPS continuamente
#if TEST_GPS
  while(Serial2.available()) gps.encode(Serial2.read());
#endif

  Serial.println();

#if TEST_BME280
  if(okBME){
    Serial.printf("BME280:  T=%.2f C  RH=%.1f %%  P=%.1f hPa\n",
                  bme.readTemperature(), bme.readHumidity(), bme.readPressure()/100.0);
  }
#endif

#if TEST_MPU6050
  if(okMPU){
    sensors_event_t a,g,tmp; mpu.getEvent(&a,&g,&tmp);
    // resta offsets: accel debe dar ~0/0/9.81 en reposo, gyro ~0/0/0
    float ax=a.acceleration.x-axOff, ay=a.acceleration.y-ayOff, az=a.acceleration.z-azOff;
    float gx=g.gyro.x-gxOff, gy=g.gyro.y-gyOff, gz=g.gyro.z-gzOff;
    Serial.printf("MPU6050: ax=%.2f ay=%.2f az=%.2f m/s2 | gx=%.3f gy=%.3f gz=%.3f rad/s\n",
                  ax, ay, az, gx, gy, gz);
  }
#endif

#if TEST_MQ135
  {
    int mv = analogReadMilliVolts(MQ_AOUT);     // mV en el ADC (tras divisor)
    float a0 = mv/1000.0 * MQ_DIV;              // V reales en A0 del modulo
    Serial.printf("MQ-135:  ADC=%d mV  A0~=%.2f V  (warmup necesario)\n", mv, a0);
  }
#endif

#if TEST_GPS
  if(gps.location.isValid()){
    Serial.printf("GPS:     %.6f, %.6f  sats=%d  alt=%.1f m\n",
                  gps.location.lat(), gps.location.lng(),
                  gps.satellites.value(), gps.altitude.meters());
  } else {
    Serial.printf("GPS:     sin fix (chars=%lu, sats=%d)\n",
                  (unsigned long)gps.charsProcessed(), gps.satellites.value());
  }
#endif

#if TEST_LORA
  if(okLoRa){
    LoRa.beginPacket();
    LoRa.printf("IGNIS-1 test seq=%lu", (unsigned long)seq);
    LoRa.endPacket();
    Serial.printf("LoRa:    TX seq=%lu\n", (unsigned long)seq);
    seq++;
  }
#endif

  delay(2000);
}
