Kaliux2412/Experimento_Abordo/(commit log)

2026-06-21 Actualizacion PCB
    [PCB_Project.PrjPcb, Placa_Principal_PCB.PcbDoc, Placa_Principal_Schematic.SchDoc]
2026-06-22 Se agregó Schema modificado de otro repo. Se agregó PCB generado con ese Schema.
    [Schema_Experimento_Abordo.kicad_pcb]
2026-06-23 Esquematico limpio y probado. PCB Actualizado. Falta definir si se cambia el U9 por un Buck-boost
    [Schema_Experimento_Abordo.kicad_pcb, Schema_Experimento_Abordo.kicad_sch]
2026-06-24 Board Cerebro - Initial Commit
    [cerebro.kicad_pcb, cerebro.kicad_sch]
2026-06-24 PCB del MCU creado
    [cerebro.kicad_pcb, cerebro.kicad_sch]
2026-06-24 PCB de RF - Initial Commit
    [rf.kicad_pcb, rf.kicad_sch]
2026-06-24 PCB Sensores - Initial Commit
    [sensores.kicad_pcb, sensores.kicad_sch]
2026-06-24 Initial Commit del project IGNIS
    [IGNIS-1.kicad_sch]
2026-06-24 IGNIS librerias inciales
    [comms_storage.kicad_sch, connectors.kicad_sch, mcu.kicad_sch, power.kicad_sch, sensors.kicad_sch]
2026-06-24 Pines corregidos en ESP32
    [cerebro.kicad_pcb, cerebro.kicad_sch]
2026-06-25 Schematic arreglado. Footprint del ESP32 ajustado.
    [cerebro.kicad_pcb, cerebro.kicad_sch]
2026-06-26 Tracks listos en PCB
    [rf.kicad_pcb, rf.kicad_sch]
2026-06-27 Placa 5 (Sensores)
    [Placa5.PrjPcb]
2026-06-28 Placa 2 GPS
    [Placa 2 (GPS).PrjPcb, Placa 2.PcbDoc, Placa2.SchDoc]
2026-06-28 Placa 3 (ESP32)
    [Placa 3 (ESP32).PrjPcb, Placa3.PcbDoc, Placa3.SchDoc]
2026-06-30 Actualizado los boards de IGNIS - separado en 3 boards
    [IGNIS-1.kicad_sch, comms_storage.kicad_sch, connectors.kicad_sch, mcu.kicad_sch, power.kicad_sch, sensores.kicad_pcb, sensores.kicad_sch, sensors.kicad_sch]
2026-06-30 Agregada documentacion de soporte
2026-07-03 Update de procedimiento de bring up y la guia educativa
2026-07-03 Fixed Footprints
2026-07-03 Update antes de mover a 4o board
    [cerebro.kicad_pcb, cerebro.kicad_sch, rf.kicad_sch, sensores.kicad_pcb, sensores.kicad_sch, sensors.kicad_sch]
2026-07-03 Updated board de sensores
    [sensores.kicad_pcb]
2026-07-05 Energia: split en 2 boards (carga + energia) y redistribucion de rieles
    - Board carga (5º): TP4056 + bateria + RBF + SW1 + TPS63020 -> +3V3 y VSW al bus
    - Board energia (4º): MT3608 -> +5V al bus (toma VSW)
    - Simbolos nuevos: TP4056, TPS63020; footprints TP4056_HW373, SW_Slide_SS12D00
    - Bus: +3V3(p1), +5V(p19), VSW(p20), GND(2/4/11); backplane a header plano
    - cerebro: quitada seccion de energia duplicada (U2/J1/J2/SW1/C1), +3V3 del bus
    - sensores: quitado MT3608 (U3), +5V del bus alimenta MQ-135/GPS
    - ZC323200 eliminado (sin uso)
    [carga.kicad_pcb, carga.kicad_sch, cerebro.kicad_pcb, cerebro.kicad_sch, energia.kicad_pcb, energia.kicad_sch, rf.kicad_sch, sensores.kicad_pcb]
2026-07-05 Backplane split: footprint+simbolo J_PWR_2x4 + checklist de recableo
    Parts para partir el backplane unico 2x10 (saturado, 19/20 pines) en
    dos buses: J_PWR (potencia, 2x4 keyed) y J_DAT (senal, reusa el 2x10).
    - footprints/IGNIS1.pretty/J_PWR_2x4_Keyed.kicad_mod: 2x4 P2.54 vertical,
    pin7 = llave anti-inversion (sin pad). Validado con kicad-cli export svg.
    - libs/IGNIS1_Symbols.kicad_sym: simbolo J_PWR_2x4 (1=+3V3 2=GND 3=+5V
    4=GND 5=VSW 6=GND 8=GND), footprint default asignado.
    - docs/Recableo_Backplane_Split.md: checklist borrar/agregar/recablear
    por board (baseline antes de recablear en GUI).
2026-07-05 Iniciando cambio de pcb de cerebro
    [cerebro.kicad_sch]
2026-07-05 wip: recableo backplane split en progreso (GUI) + doc con move TPS63020
    [carga.kicad_pcb, carga.kicad_sch, cerebro.kicad_sch, energia.kicad_pcb, energia.kicad_sch, sensores.kicad_sch]
2026-07-05 5 boards separados, falta ajustar dimensiones de BME280 y MQ-135
    [carga.kicad_pcb, carga.kicad_sch, cerebro.kicad_pcb, cerebro.kicad_sch, energia.kicad_pcb, energia.kicad_sch, rf.kicad_pcb, rf.kicad_sch]
2026-07-06 Se agregaron tracks. PCB Cerebro libre de errores.
    [carga.kicad_pcb, cerebro.kicad_pcb, energia.kicad_pcb, rf.kicad_pcb, sensores.kicad_pcb]
2026-07-06 Todos los boards pasan el check, tracks completos
    [carga.kicad_pcb, energia.kicad_pcb, rf.kicad_pcb, sensores.kicad_pcb]
2026-07-06 Export SVGs de cobre (5 boards) + doc de generacion para grabado
    - fab_svg/: F.Cu (top) + B.Cu espejado (bot) por board, 1:1 mm, positivo,
    zonas rellenadas, sin marco. Generados con kicad-cli 10.0.4.
    - docs/Generacion_SVG_para_grabado.md: comandos, flags, checklist para el
    operador (escala/positivo-negativo/centerline/espejo/registro), rol de
    Inkscape, flujos alternativos (Gerber->FlatCAM para CNC).
2026-07-06 Actualización archivos KiCad
    [sensores.kicad_pcb]
2026-07-06 Footprint BME280 propio + asignado (board sensores)
    - Nuevo footprint IGNIS1:BME280_module (13.6x10.4mm, 4 THT P2.54
    VCC/GND/SCL/SDA, agujero montaje 3mm arriba-derecha).
    - Asignado en simbolo maestro (default) y en instancia U20 del esquematico.
    - PCB sensores: U20 cambia de PinHeader_1x04 generico a BME280_module;
    tracks viejos de U20 removidos (pads reubicados, falta rerutear).
    [sensores.kicad_pcb, sensores.kicad_sch, sensors.kicad_sch]
2026-07-06 Actualización sensores.kicad_pcb
    [sensores.kicad_pcb]
2026-07-14 Agregar boards_backup_2 con las 5 PCBs
    [carga.kicad_pcb, carga.kicad_sch, cerebro.kicad_pcb, cerebro.kicad_sch, energia.kicad_pcb, energia.kicad_sch, rf.kicad_pcb, rf.kicad_sch]
2026-07-21 Split IGNIS-1 en 2 placas de 58x100 unidas por bus J50 2x06
    La placa unificada 100x60 no cupo en el tubo. Se divide en dos placas
    apiladas en sandwich, unidas por header macho/hembra sin cables.
    Placa A (placa_poder_cerebro/): ESP32, LoRa, microSD, TPS63020, buzzer.
    Placa B (placa_sensores/): BME280, MPU6050, MQ-135, GPS, MT3608, TP4056,
    bateria.
    El TPS63020 se queda en A para regular el 3V3 junto a sus consumidores
    con transitorios. El boost 5V y el bloque carga/bateria pasan a B, que
    es donde esta el unico consumidor de 5V (MQ-135). Como consecuencia VSW
    cruza el bus y +5V ya no lo hace.
    Bus J50: 9 nets en conector 2x06 (VSW x2, GND x3, +3V3, SDA, SCL,
    GPS_TX, GPS_RX, MPU_INT, MQ_AOUT).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
    [placa_poder_cerebro.kicad_pcb, placa_poder_cerebro.kicad_sch, placa_sensores.kicad_pcb, placa_sensores.kicad_sch, placa_unificada.kicad_pcb, placa_unificada.kicad_sch, sub_boost.kicad_sch, sub_carga.kicad_sch]
2026-07-21 Ignorar archivos de preferencias locales de KiCad (.kicad_prl)
    Los .kicad_prl guardan estado de UI por usuario (viewport, capas visibles,
    zoom) y cambian con solo abrir el proyecto. Tenerlos en git genera conflictos
    constantes ahora que hay dos personas trabajando sobre las placas.
    Se dejan de trackear con `git rm --cached`; los archivos permanecen en disco.
2026-07-23 Rutear placa_poder_cerebro y reposicionar footprints de placa_sensores
    [placa_poder_cerebro.kicad_pcb, placa_sensores.kicad_pcb]
